MiniWindTunnelProject/The-Mini-Wind-Tunnel-Project/assets/img/about/3.jpg

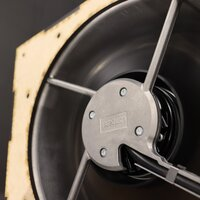
assets/img/about/3.jpg
