MiniWindTunnelProject/The-Mini-Wind-Tunnel-Project/assets/img/about/1.jpg

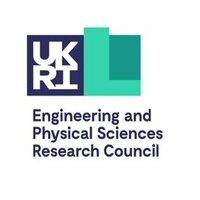
assets/img/about/1.jpg
