MiniWindTunnelProject/The-Mini-Wind-Tunnel-Project/README.md

# The-Mini-Wind-Tunnel-Project
Files to build a [mini wind tunnel](https://miniwindtunnelproject.github.io/The-Mini-Wind-Tunnel-Project/)

Files will be uploaded soon!
