MiniWindTunnelProject/The-Mini-Wind-Tunnel-Project/assets/img/about/2.jpg

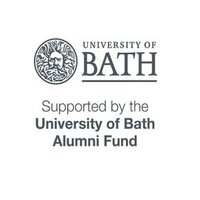
assets/img/about/2.jpg
