MiniWindTunnelProject/The-Mini-Wind-Tunnel-Project/assets/img/about/4.jpg

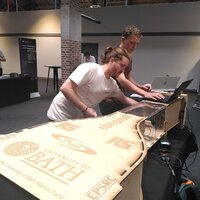
assets/img/about/4.jpg
