MiniWindTunnelProject/The-Mini-Wind-Tunnel-Project/assets/img/about/5.jpg

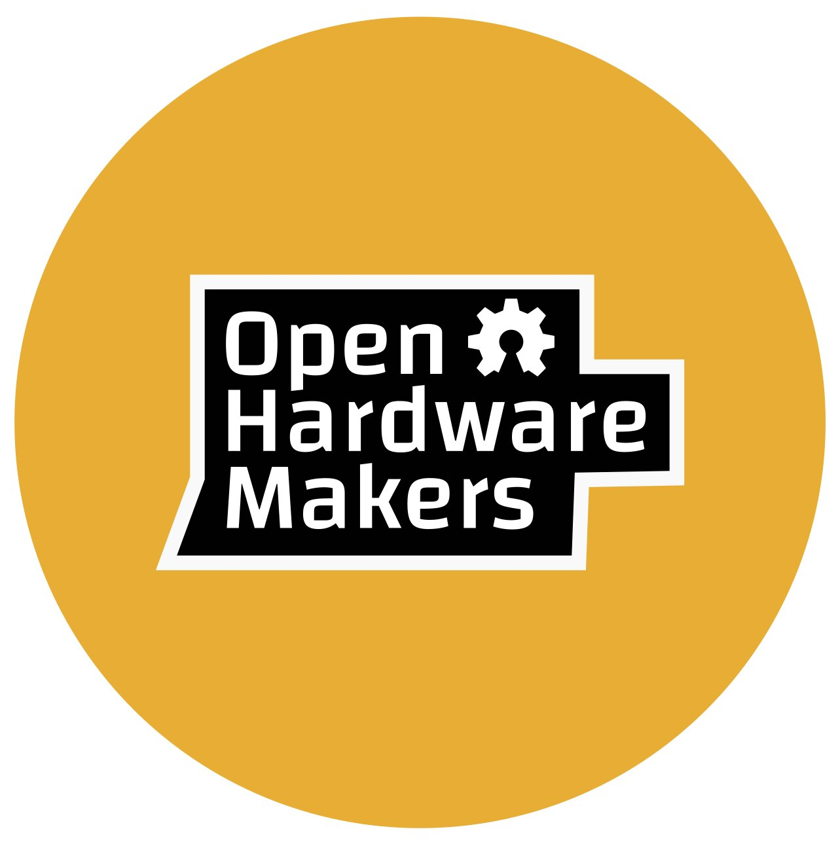
assets/img/about/5.jpg
