MiniWindTunnelProject/The-Mini-Wind-Tunnel-Project/assets/img/Mk5.png

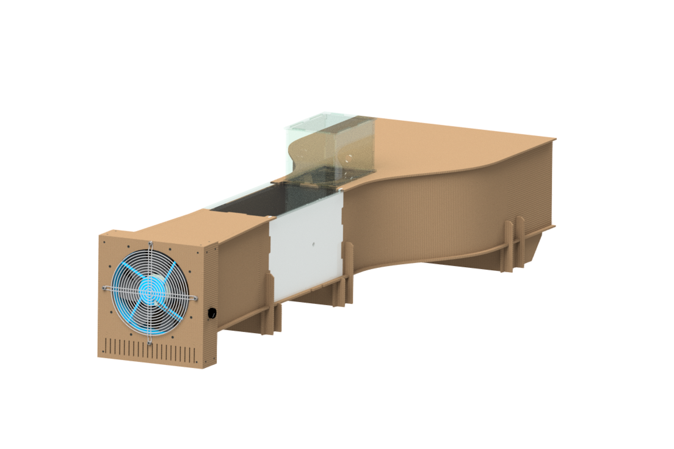
assets/img/Mk5.png
