MiniWindTunnelProject/The-Mini-Wind-Tunnel-Project/assets/img/teaching.jpg

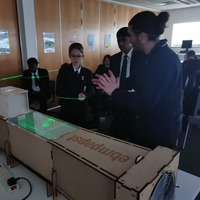
assets/img/teaching.jpg
