MiniWindTunnelProject/The-Mini-Wind-Tunnel-Project/assets/img/team/1.jpg

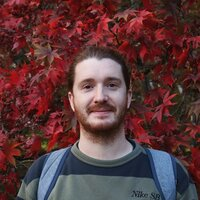
assets/img/team/1.jpg
