MiniWindTunnelProject/The-Mini-Wind-Tunnel-Project/assets/img/team/2.png

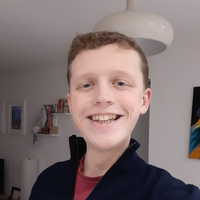
assets/img/team/2.png
