MiniWindTunnelProject/The-Mini-Wind-Tunnel-Project/assets/img/team/3.jpg

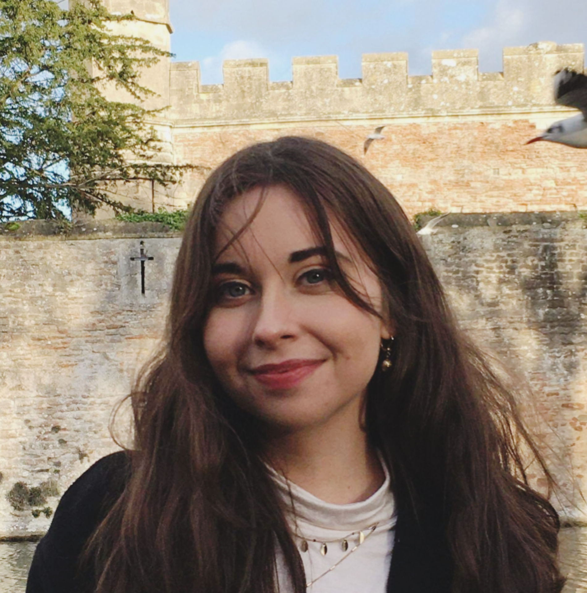
assets/img/team/3.jpg
