MiniWindTunnelProject/The-Mini-Wind-Tunnel-Project/Cost Sheet.xlsx

Powerpack | 72.07 | https://www.powersuppliesonline.co.uk/power-supplies/led-lighting-power-supplies/elg-series-mean-well/elg-300-24a-300w-24v-12-5a-led-lighting-power-supply.html
Fan | 294.21 | https://www.mouser.co.uk/ProductDetail/ebm-papst/W1G250-HJ87-02?qs=Cb2nCFKsA8o3UJP6PgA8lw%3D%3D
10 V regulator | 2.62 | https://uk.rs-online.com/web/p/voltage-regulators/5339381?matchtype=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
Control Knob | 7.57 | https://uk.rs-online.com/web/p/potentiometer-knobs/4659870
Fan Controller | 19.18 | https://uk.rs-online.com/web/p/fan-speed-controllers/7434807?matchtype=&pla-529871992272&gclsrc=aw.ds
Connector strip | 1.28 | https://www.toolstation.com/connector-strip/p19539?store=A6&pcrid=&pkw=&pmt=&gclsrc=aw.ds
M3 knurled brass inserts | 16.61 | https://uk.rs-online.com/web/p/threaded-inserts/0278534
Fan guard | 32.63 | https://uk.rs-online.com/web/p/finger-guards/2781559?matchtype=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
Nuts, Bolts, Washers |  | https://www.westfieldfasteners.co.uk/ |  | Minimum Order Quantites (MOQ) apply here. Perhaps smaller MOQs apply elsewhere? | Ebay?
 | 1.99 | 20 x Nyloc Nut Type T (Thin) M3 in A2 Stainless
 | 2.07 | 20 x Nyloc Nut Type T (Thin) M4 in A2 Stainless
 | 2.1 | 8 x Nyloc Nut Type T (Thin) M6 in A2 Stainless
 | 3.3 | 30 x Socket Head Countersunk Screw M3 x 12mm in A2 Stainless
 | 3.49 | 30 x Socket Head Countersunk Screw M3 x 20mm in A2 Stainless
 | 3.19 | 20 x Socket Head Countersunk Screw M4 x 16mm in A2 Stainless
 | 2.1 | 8 x Socket Head Countersunk Screw M6 x 16mm in A2 Stainless
 | 2.41 | 15 x DIN 9021 Washer M6 in A2 Stainless
 | 3.5 | delivery
 | 28.98 | Total + 20% VAT
Laser level | 15.82 | https://www.amazon.co.uk/Evaliss-Multipurpose-Horizontal-Rechargeable-Measuring/dp/B09F6GVCMX
Microfogger 3 lite with remote | 225 | https://levshop.co.uk/product/microfogger-3-lite
Ruler | 1.96 | https://uk.rs-online.com/web/p/rulers/1923661
Springs | 12.59 | https://uk.rs-online.com/web/p/extension-springs/0821396
Level | 2.11 | https://uk.rs-online.com/web/p/spirit-levels-inclinometers/8513539
2440 x 1220 x 6mm Flexible MDF Long Grain FSC (ring for quote) NOTE: you will need to get sydenams to break it down into manageable chunks for the laser cutter bed size. For my application, this cost £5 (3 of 700x1000mm) | 75 | https://www.sydenhams.co.uk/timber/sheet-materials/medium-density-fibreboard-(mdf)/
ESTIMATES
Laser cutting costs | 150 |  | https://www.finecut.co.uk/processes/cutting/laser-cutting/
3D printing costs | 100 |  | 3dpeople.uk
Grand Total | 1057.63
