MiniWindTunnelProject/The-Mini-Wind-Tunnel-Project/Mini Wind Tunnel Files/3D print/CornerPiece.stp

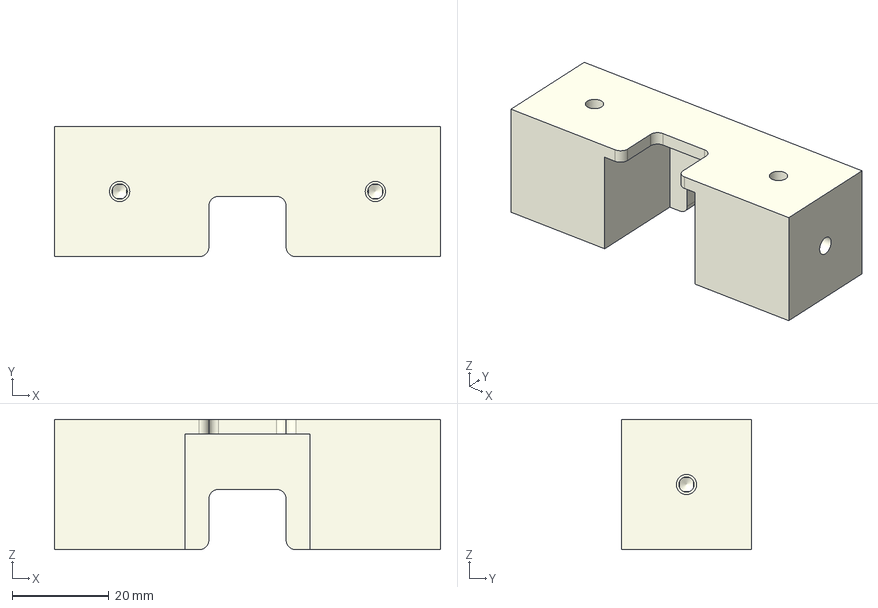
[picture p11: CAD file, 2022-11-02]
Mini Wind Tunnel Files/3D print/CornerPiece.stp
80.0 x 27.0 x 27.0 mm
