MiniWindTunnelProject/The-Mini-Wind-Tunnel-Project/Mini Wind Tunnel Files/Laser Cut Drawings/6mm Acryllic/SmokeBox.dxf

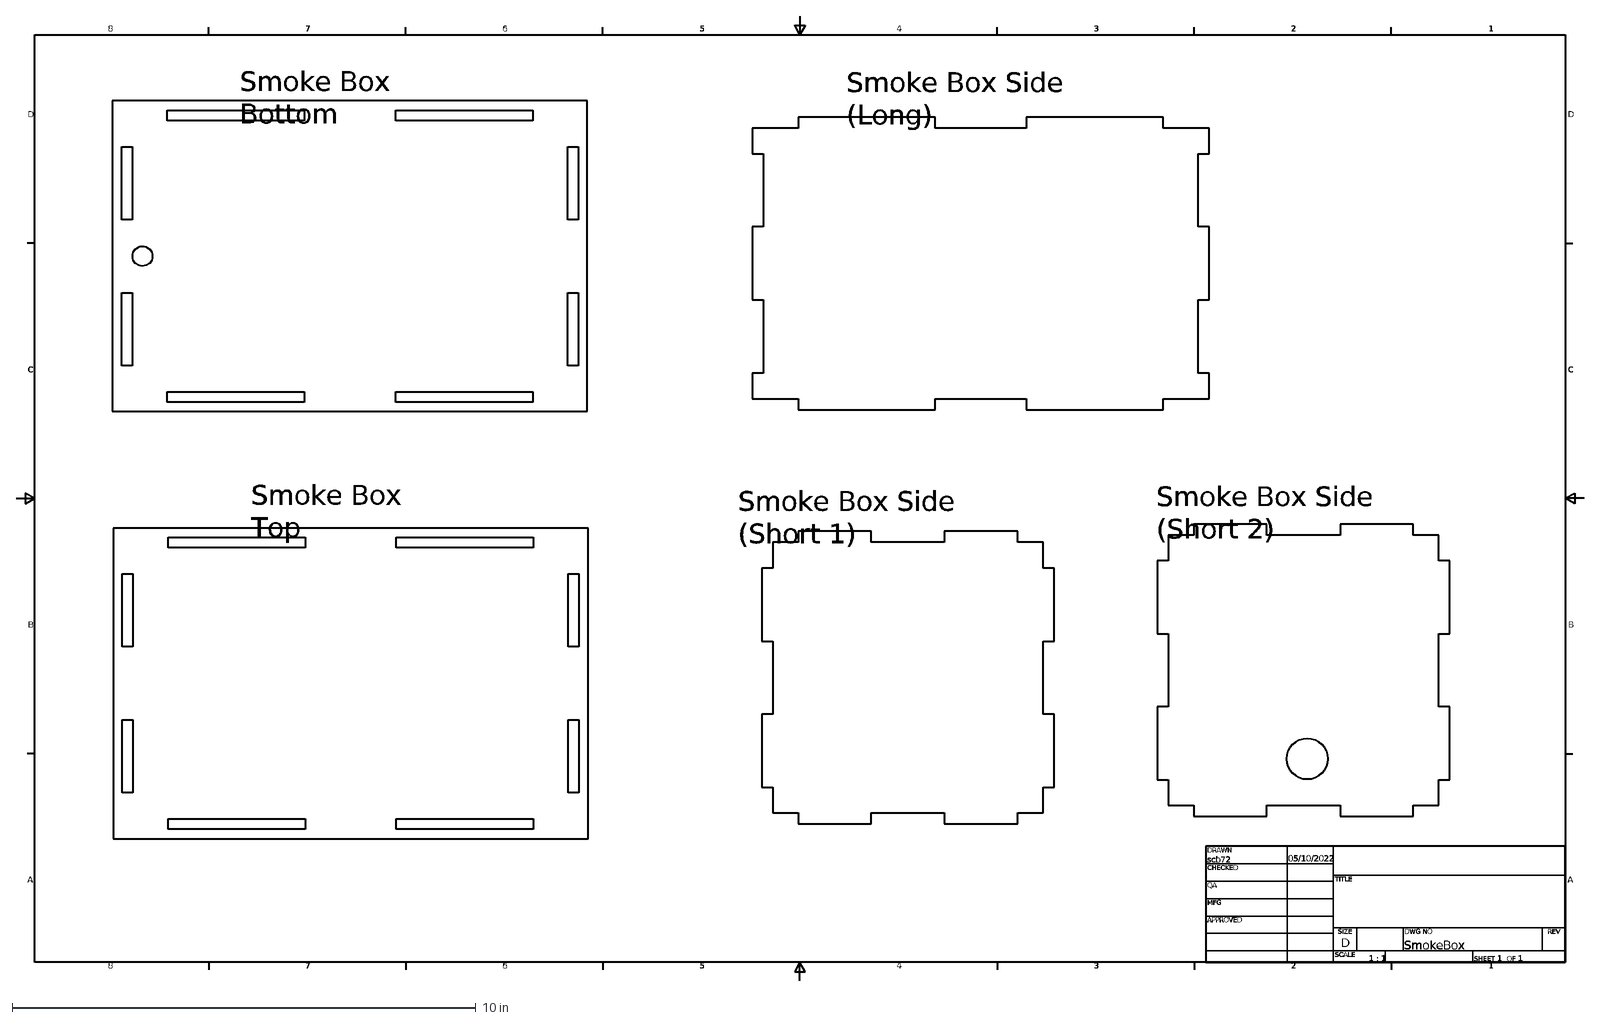
[picture p12: CAD file, 2022-11-02]
Mini Wind Tunnel Files/Laser Cut Drawings/6mm Acryllic/SmokeBox.dxf
1
2
3
4
5
6
7
8
A
B
C
D
scb72
05/10/2022
SmokeBox
1 : 1
SHEET 1 OF 1
DRAWN
CHECKED
QA
MFG
APPROVED
DWG NO
TITLE
SIZE
SCALE
REV
Smoke Box Bottom
Smoke Box Top
Smoke Box Side (Long)
Smoke Box Side (Short 1)
Smoke Box Side (Short 2)
