MiniWindTunnelProject/The-Mini-Wind-Tunnel-Project/Mini Wind Tunnel Files/Laser Cut Drawings/6mm MDF/LaserHolder.dxf

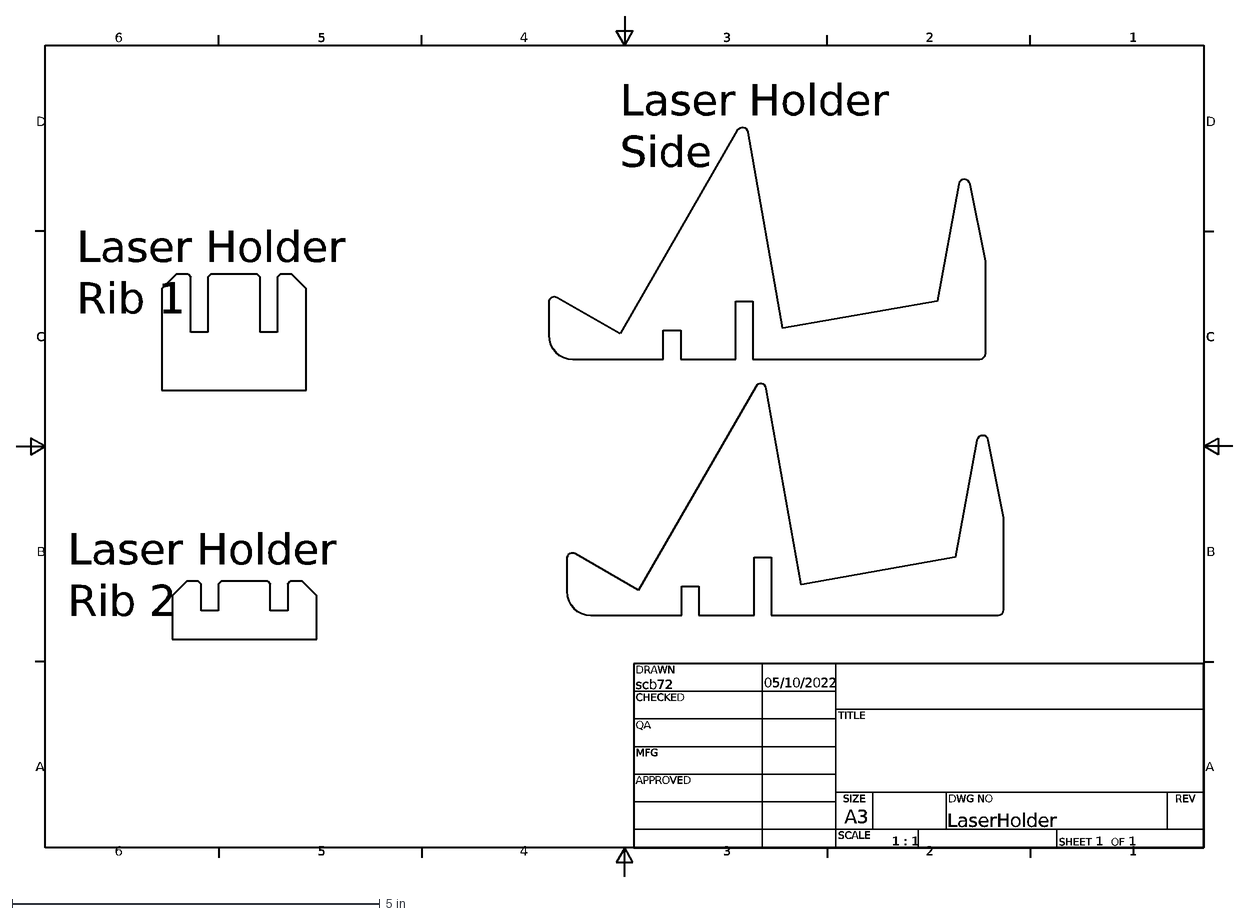
[picture p13: CAD file, 2022-11-02]
Mini Wind Tunnel Files/Laser Cut Drawings/6mm MDF/LaserHolder.dxf
1
2
3
4
5
6
A
B
C
D
scb72
05/10/2022
LaserHolder
A3
1 : 1
SHEET 1 OF 1
DRAWN
CHECKED
QA
MFG
APPROVED
DWG NO
TITLE
SIZE
SCALE
REV
Laser Holder Side
Laser Holder Rib 1
Laser Holder Rib 2
