MiniWindTunnelProject/The-Mini-Wind-Tunnel-Project/(list of files, cad)

Other CAD files:
Mini Wind Tunnel Files/Countersink locations/Motorbox Fan Front.dwg
Mini Wind Tunnel Files/Laser Cut Drawings/6mm Acryllic/Test Section.dxf
Mini Wind Tunnel Files/Laser Cut Drawings/6mm Flex MDF/Contraction.dxf
Mini Wind Tunnel Files/Laser Cut Drawings/6mm MDF/Diffuser.dxf
Mini Wind Tunnel Files/Countersink locations/Motorbox side 1.dwg
Mini Wind Tunnel Files/Laser Cut Drawings/6mm Flex MDF/Diffuser.dxf
Mini Wind Tunnel Files/Laser Cut Drawings/6mm MDF/Contraction.dxf
Mini Wind Tunnel Files/Countersink locations/Motorbox top.dwg
Mini Wind Tunnel Files/Laser Cut Drawings/6mm MDF/Motorbox.dxf
Mini Wind Tunnel Files/Countersink locations/Motorbox Fan Front 2.dwg
Mini Wind Tunnel Files/Laser Cut Drawings/6mm MDF/Test Section_Sheet.dxf
Mini Wind Tunnel Files/Countersink locations/Motorbox corner piece.dwg
Mini Wind Tunnel Files/Laser Cut Drawings/6mm MDF/Test Section.dwg
Mini Wind Tunnel Files/Countersink locations/Motorbox Bottom.dwg
Mini Wind Tunnel Files/Countersink locations/Motorbox side 2.dwg
Mini Wind Tunnel Files/Countersink locations/Motorbox Fan Back.dwg
Mini Wind Tunnel Files/3D print/CornerPiece.ipt
Mini Wind Tunnel Files/3D print/CornerPiece.stl
Mini Wind Tunnel Files/Laser Cut Drawings/6mm Acryllic/SmokeBox.dwg
Mini Wind Tunnel Files/Laser Cut Drawings/6mm Acryllic/Test Section.dwg
Mini Wind Tunnel Files/Laser Cut Drawings/6mm Flex MDF/Contraction.dwg
Mini Wind Tunnel Files/Laser Cut Drawings/6mm Flex MDF/Diffuser.dwg
Mini Wind Tunnel Files/Laser Cut Drawings/6mm MDF/Contraction.dwg
Mini Wind Tunnel Files/Laser Cut Drawings/6mm MDF/Diffuser.dwg
Mini Wind Tunnel Files/Laser Cut Drawings/6mm MDF/LaserHolder.dwg
Mini Wind Tunnel Files/Laser Cut Drawings/6mm MDF/Motorbox.dwg
