MiniWindTunnelProject/The-Mini-Wind-Tunnel-Project/Mini Wind Tunnel Files/Fan Wiring.docx

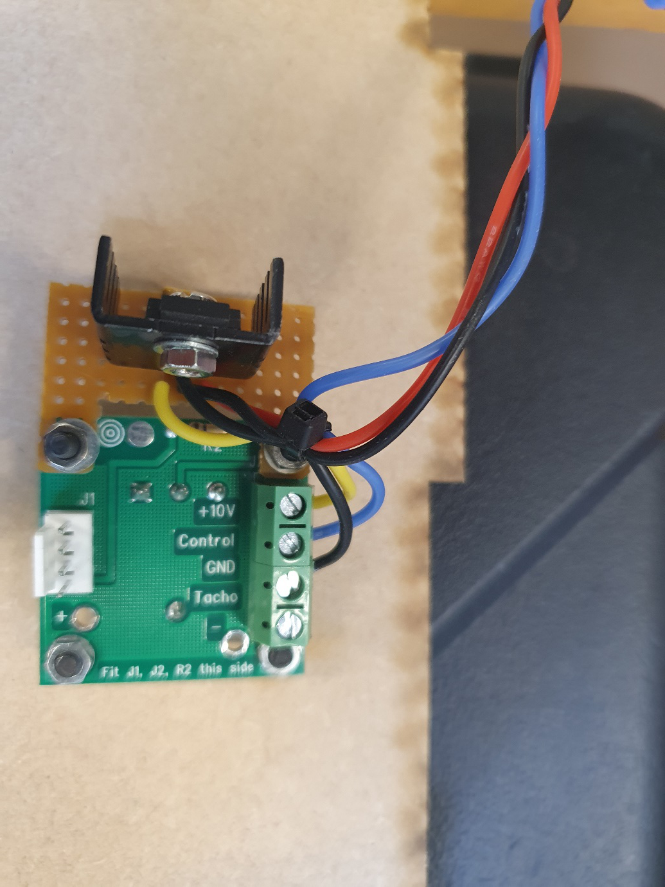
[picture p14: figure]

The speed is controlled using a10K potentiometer which is mounted on a PCB

The supply used is 10V from a 10V regulator, the heat sink is from CPC, order code 170072.

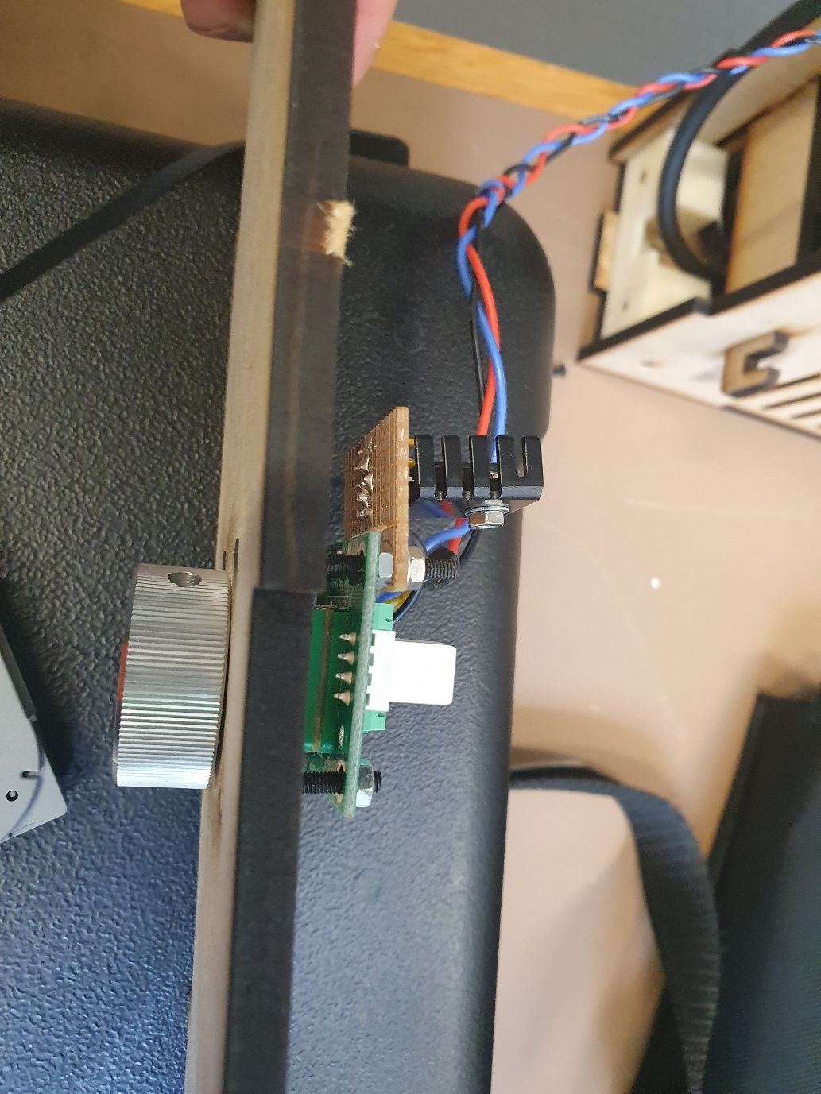
[picture p15: figure]

View from the top

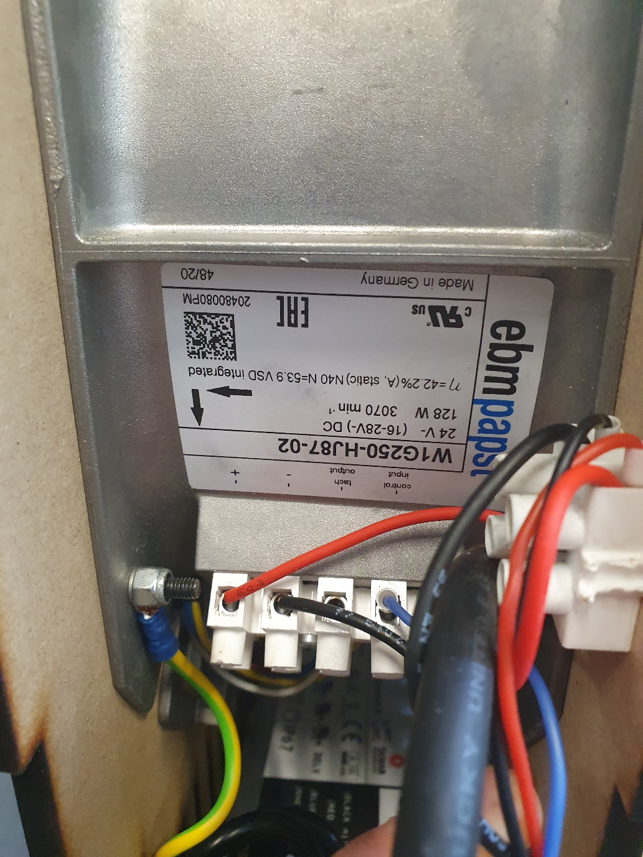
[picture p16: figure]

The Fan details, 24V coming in on red and black wires and the speed demand coming in on the blue wire.

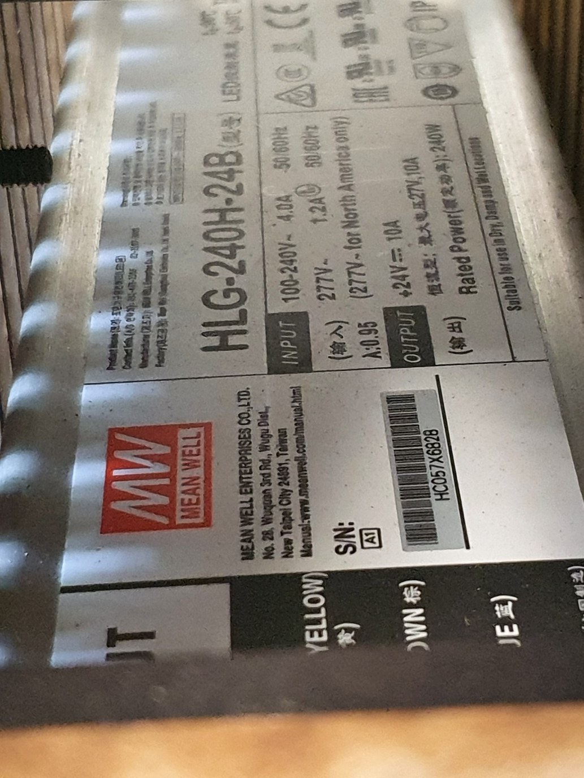
[picture p17: figure]

This is power supply for the Fan 24V.

So a simple setup with 0-10V demand for the speed from the 10K pot and a power supply to supply the Fan.
