MiniWindTunnelProject/The-Mini-Wind-Tunnel-Project/assets/img/GitBuildingScreenshot.JPG

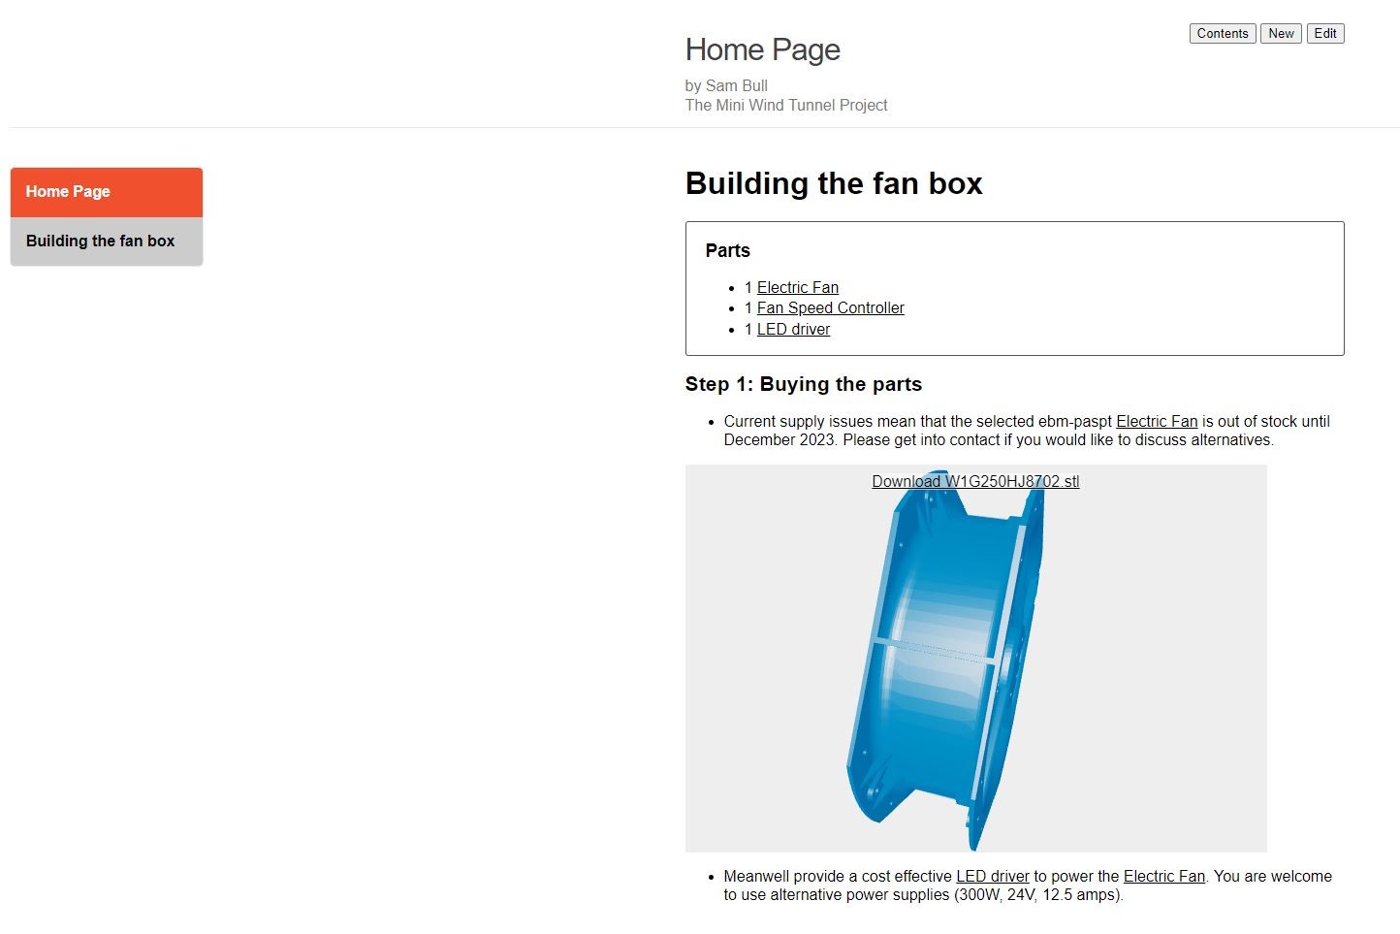
assets/img/GitBuildingScreenshot.JPG
