MiniWindTunnelProject/The-Mini-Wind-Tunnel-Project/Mini Wind Tunnel Files/Assembly Drawings/Laser Holder/LaserHolder.pdf

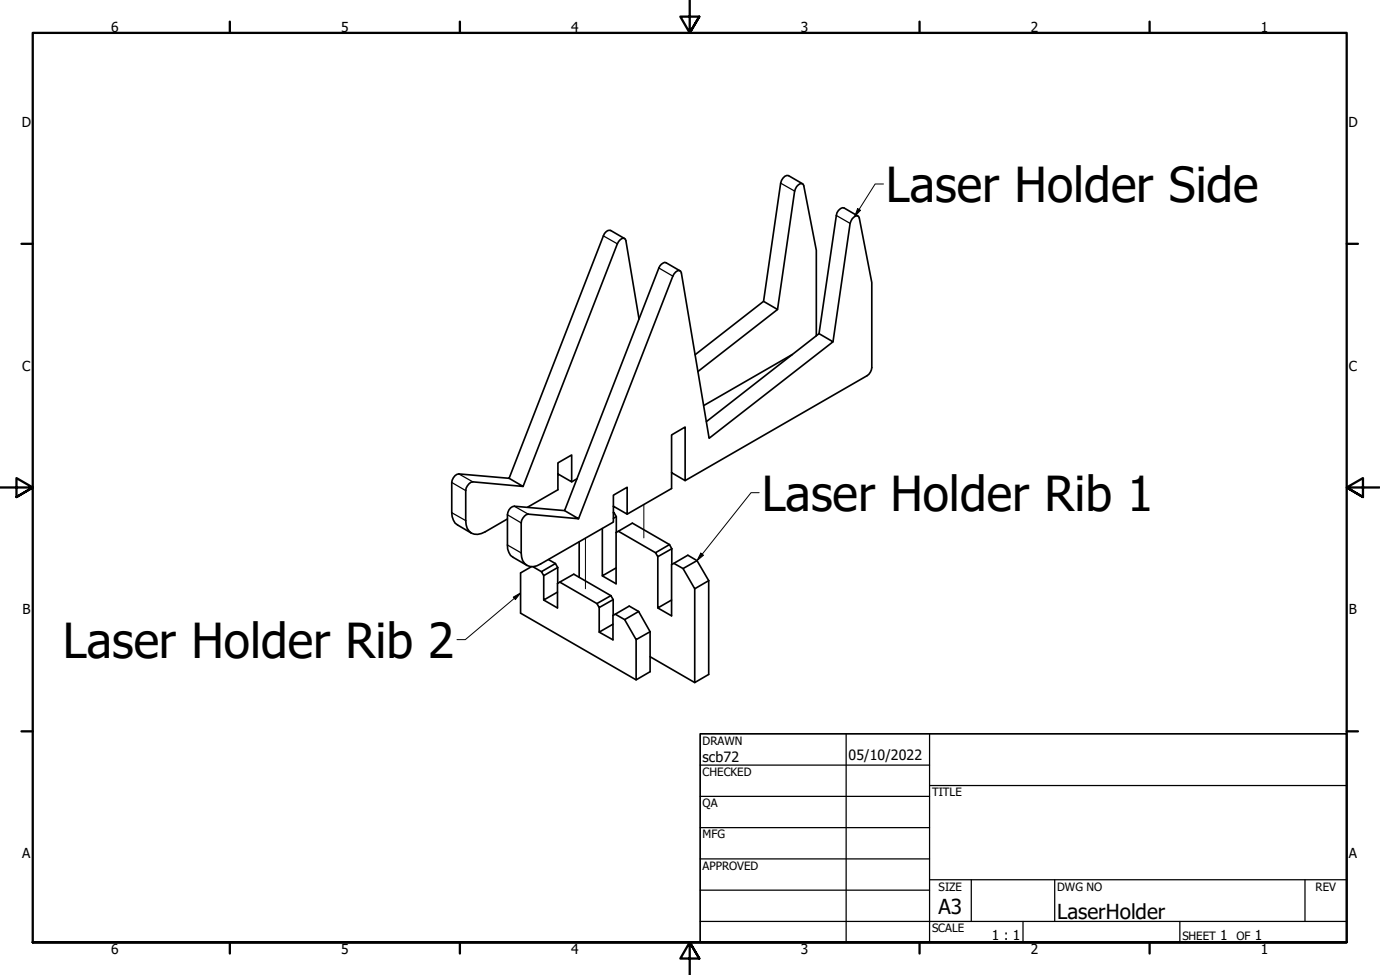
[picture p19: page 1]

Laser Holder Side

Laser Holder Rib 1

Laser Holder Rib 2

DRAWN scb72 | 05/10/2022

CHECKED

MFG

APPROVED

SIZE A3 | DWG NO LaserHolder | REV

SCALE 1 : 1 | | SHEET 1 OF 1
