MiniWindTunnelProject/The-Mini-Wind-Tunnel-Project/Mini Wind Tunnel Files/Assembly Drawings/Motorbox/Motorbox Bottom_cornerpiece assembly.pdf

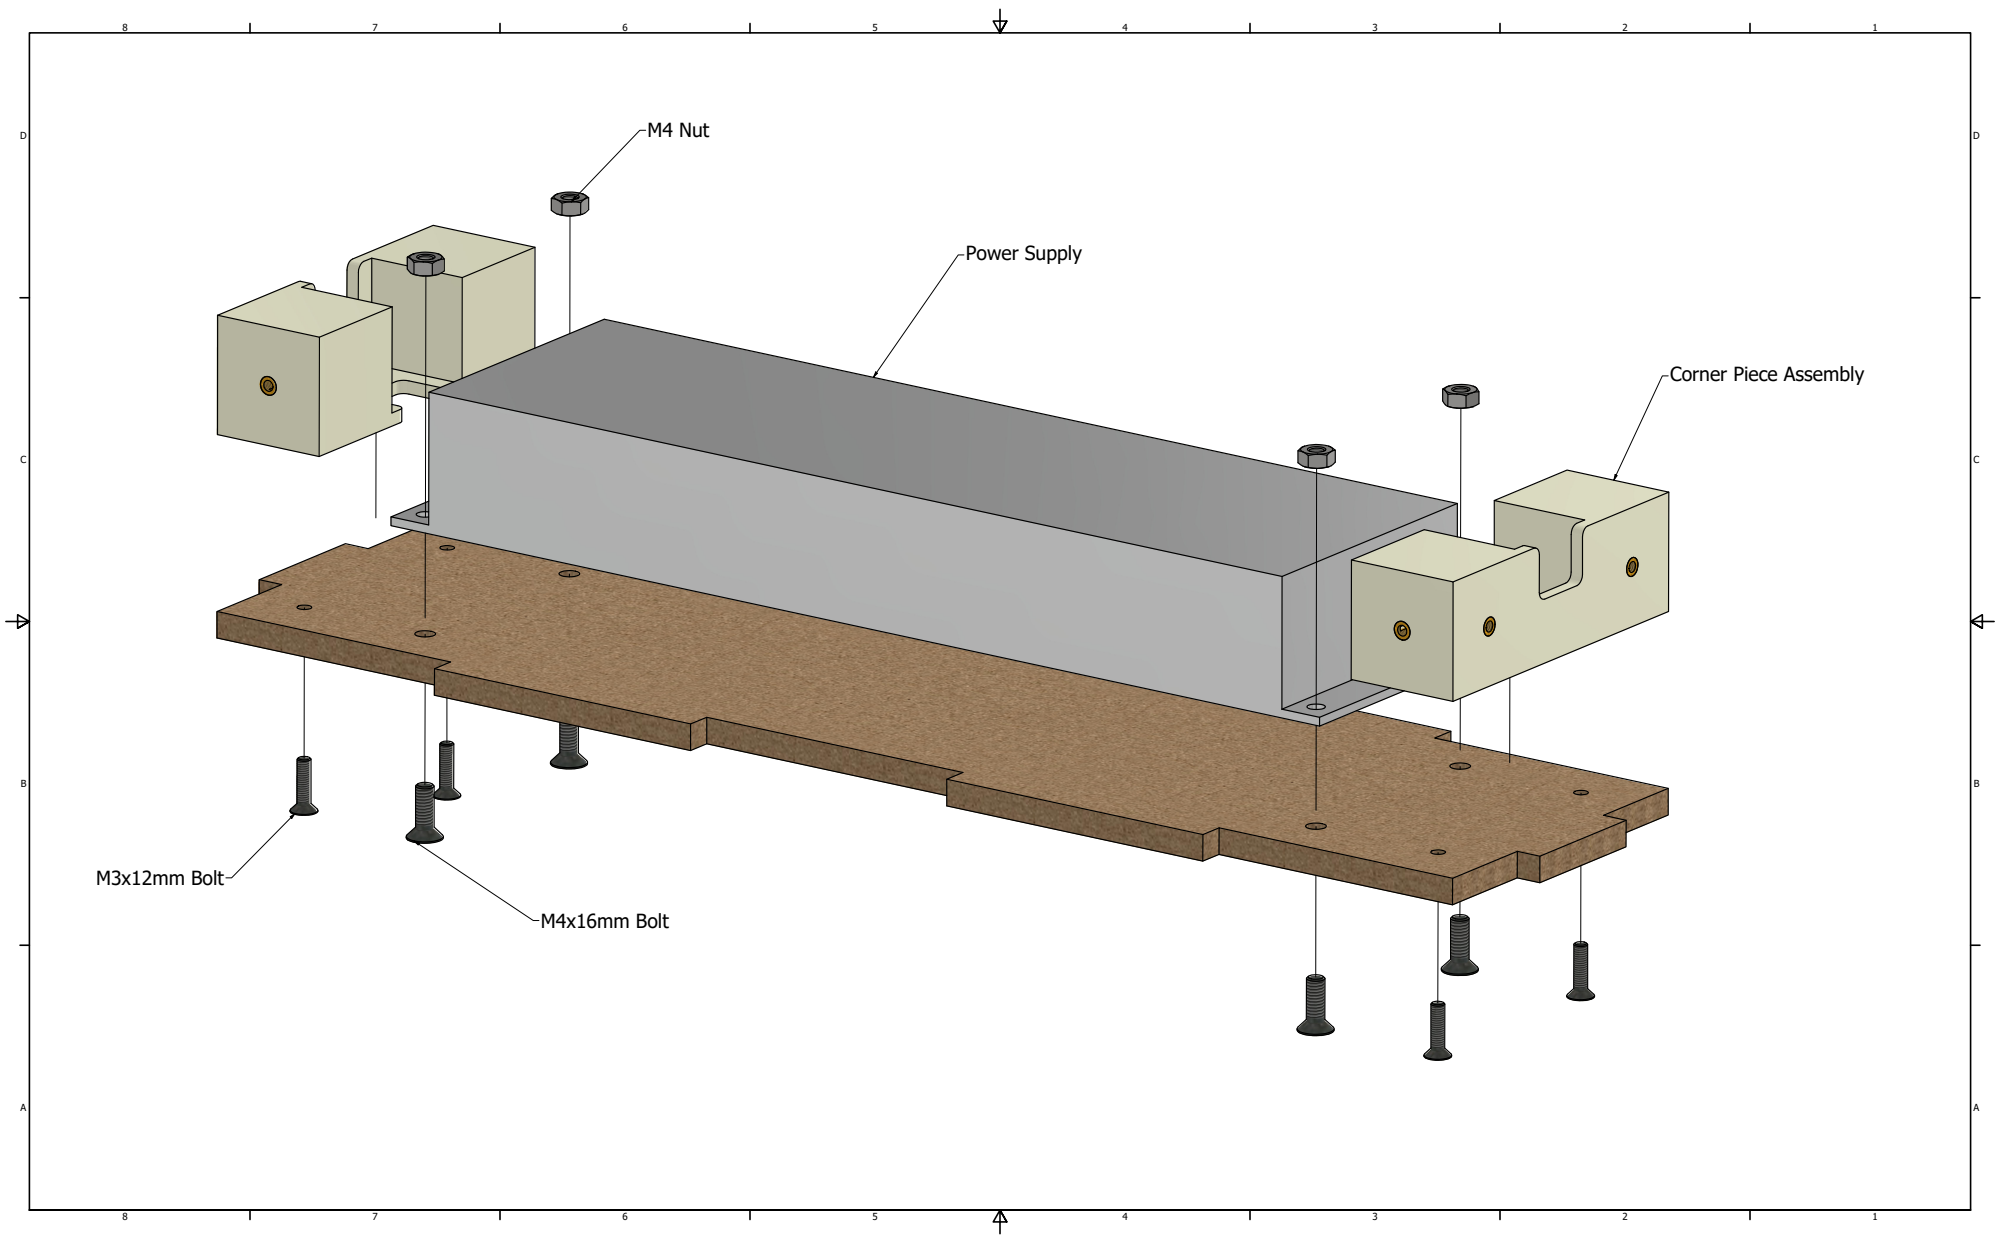
[picture p20: page 1]
Power Supply; M4 Nut; M4x16mm Bolt; M3x12mm Bolt

Corner Piece Assembly
