MiniWindTunnelProject/The-Mini-Wind-Tunnel-Project/Mini Wind Tunnel Files/Assembly Drawings/Motorbox/Motorbox Top_cornerpiece assembly.pdf

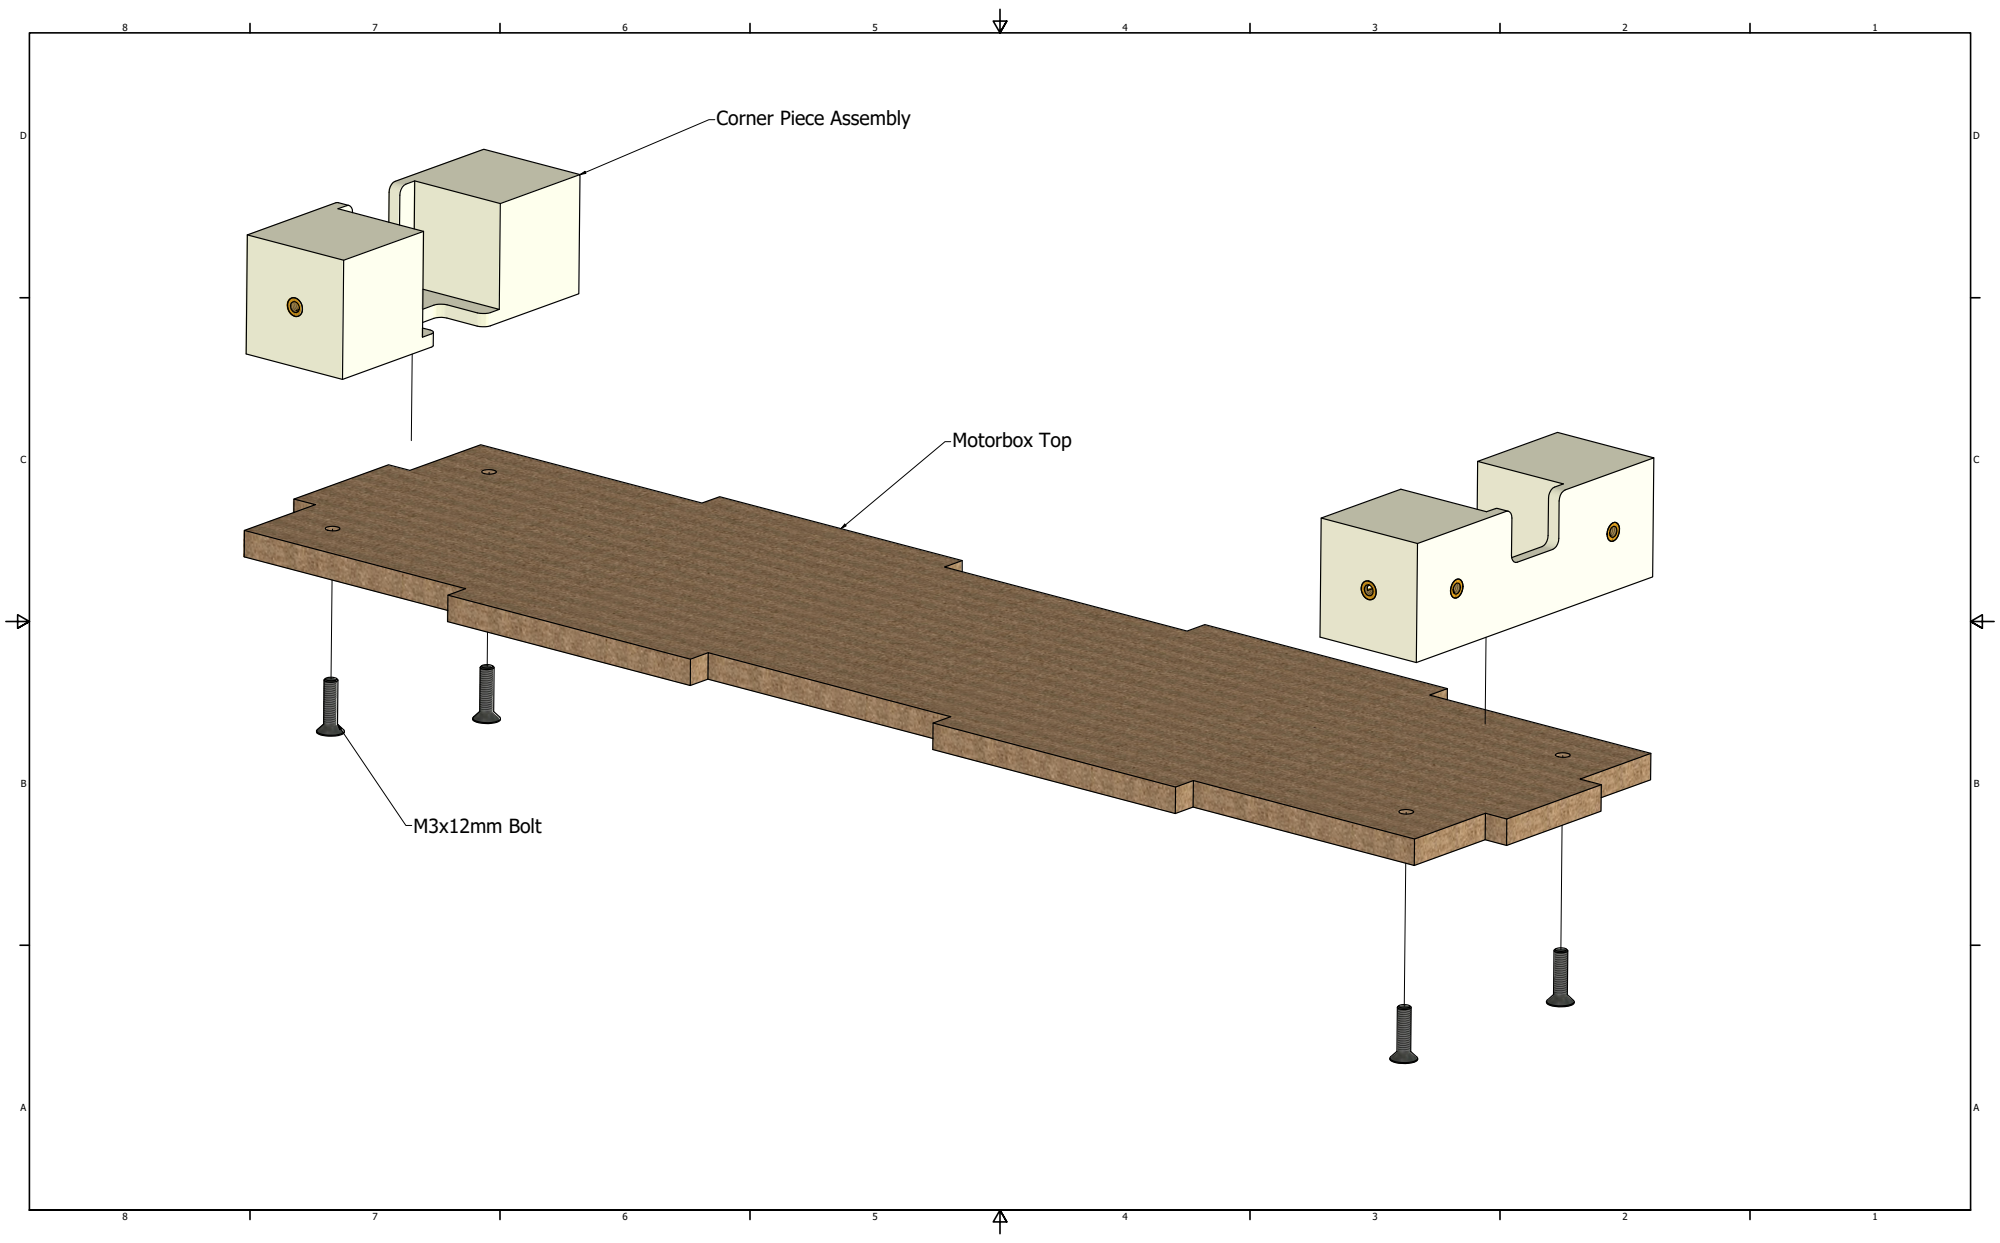
[picture p21: page 1]
Motorbox Top; M3x12mm Bolt

Corner Piece Assembly
