MiniWindTunnelProject/The-Mini-Wind-Tunnel-Project/Mini Wind Tunnel Files/Assembly Drawings/Motorbox/MotorBox_frontback.pdf

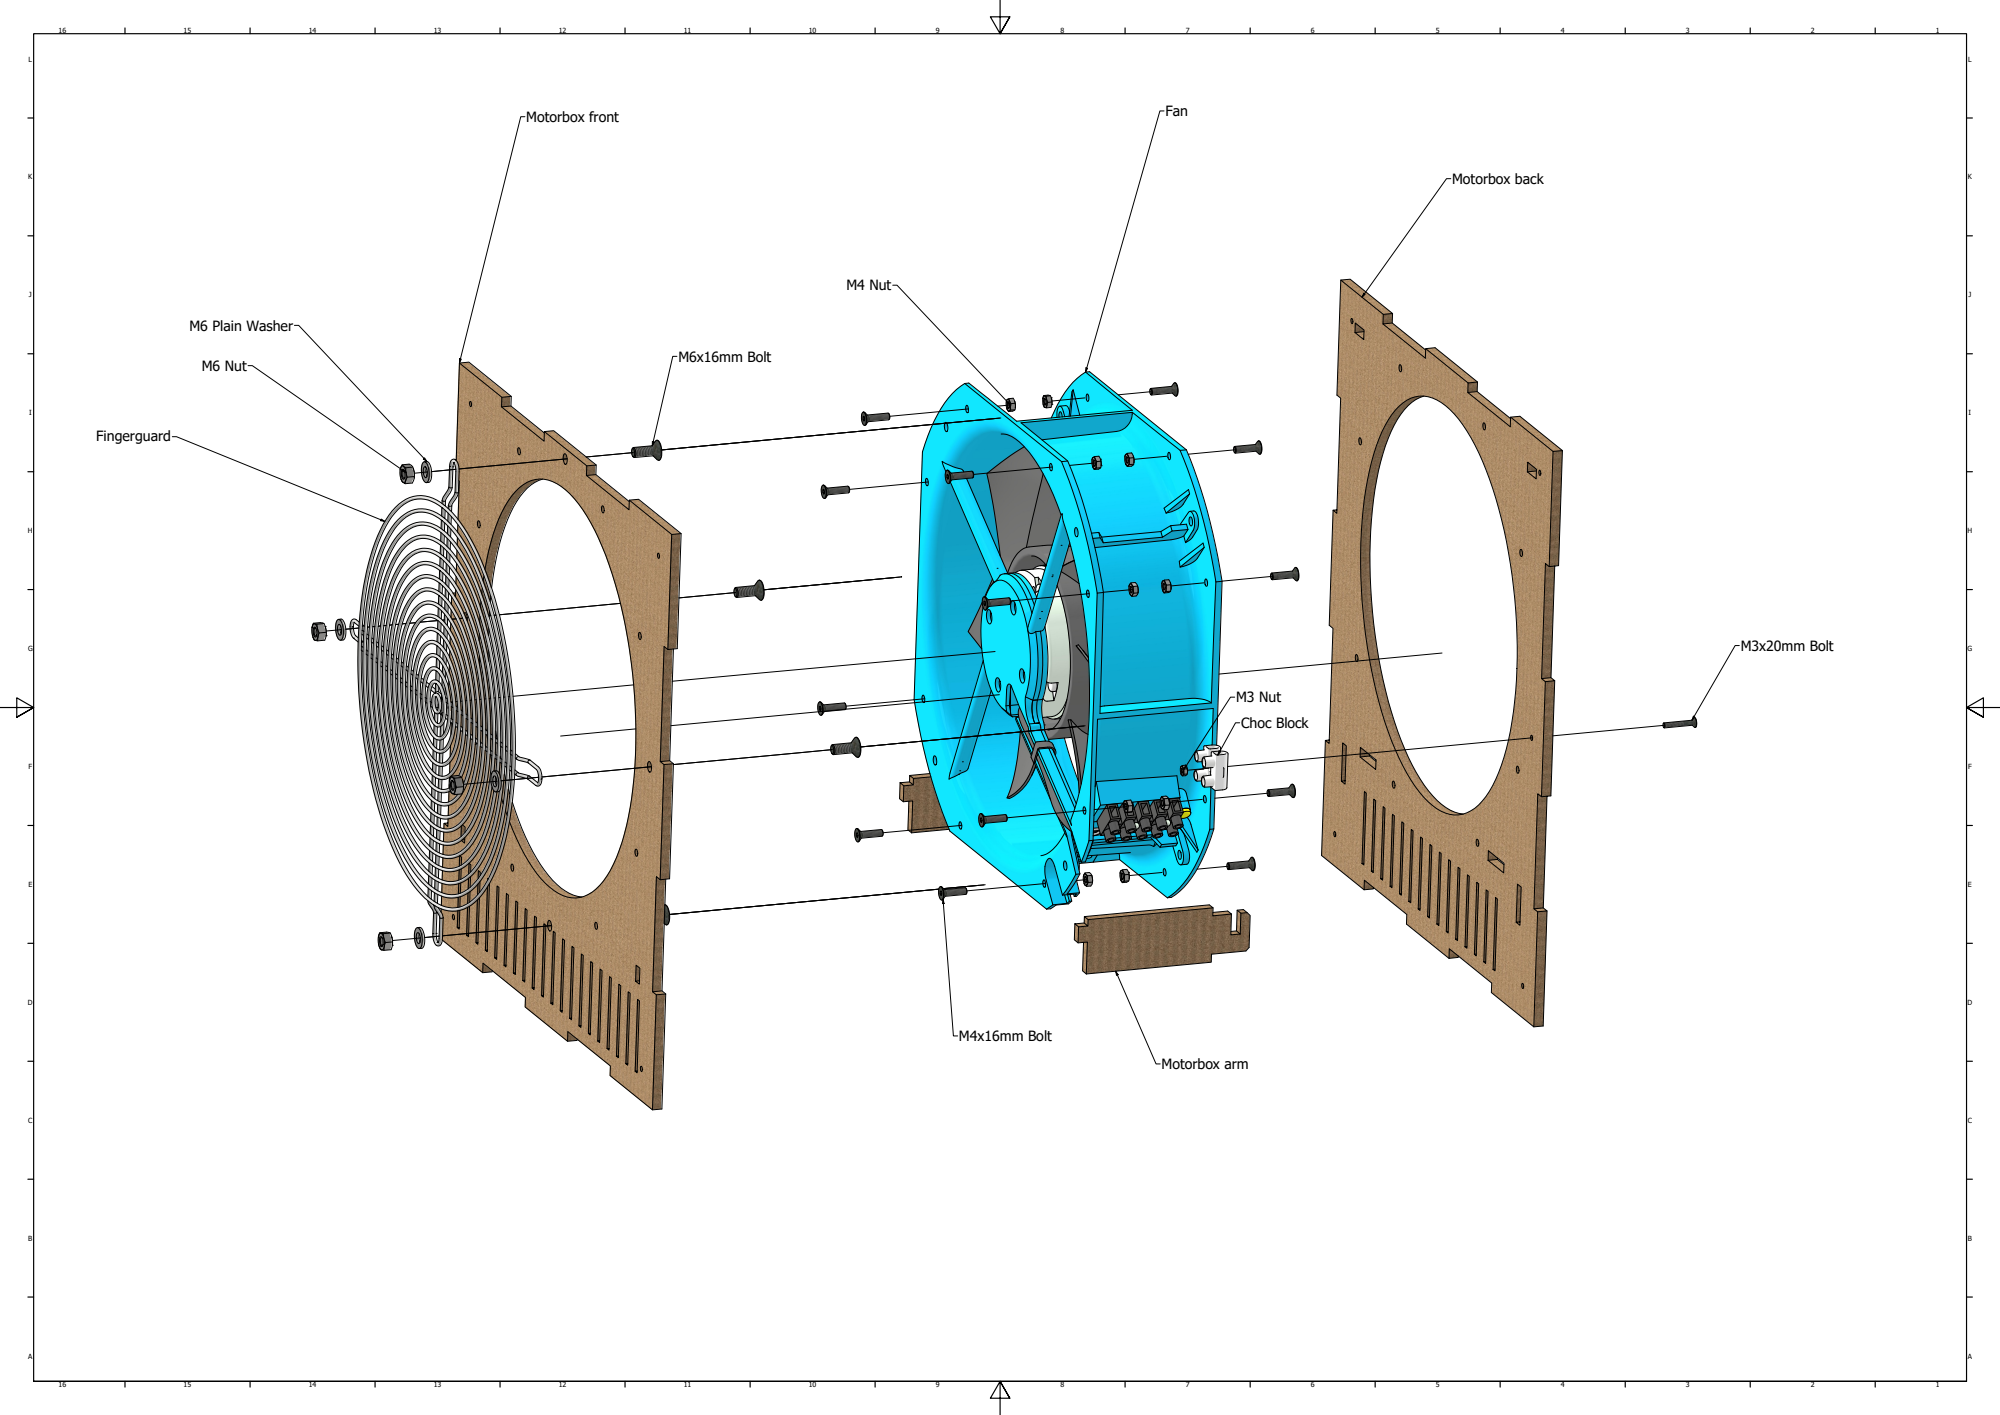
[picture p22: page 1]
Motorbox back; Motorbox front; M3x20mm Bolt; Motorbox arm; M4x16mm Bolt; M4 Nut; M6x16mm Bolt; M6 Nut; M6 Plain Washer; Choc Block; M3 Nut
