MiniWindTunnelProject/The-Mini-Wind-Tunnel-Project/Mini Wind Tunnel Files/Assembly Drawings/Motorbox/Side_Controller.pdf

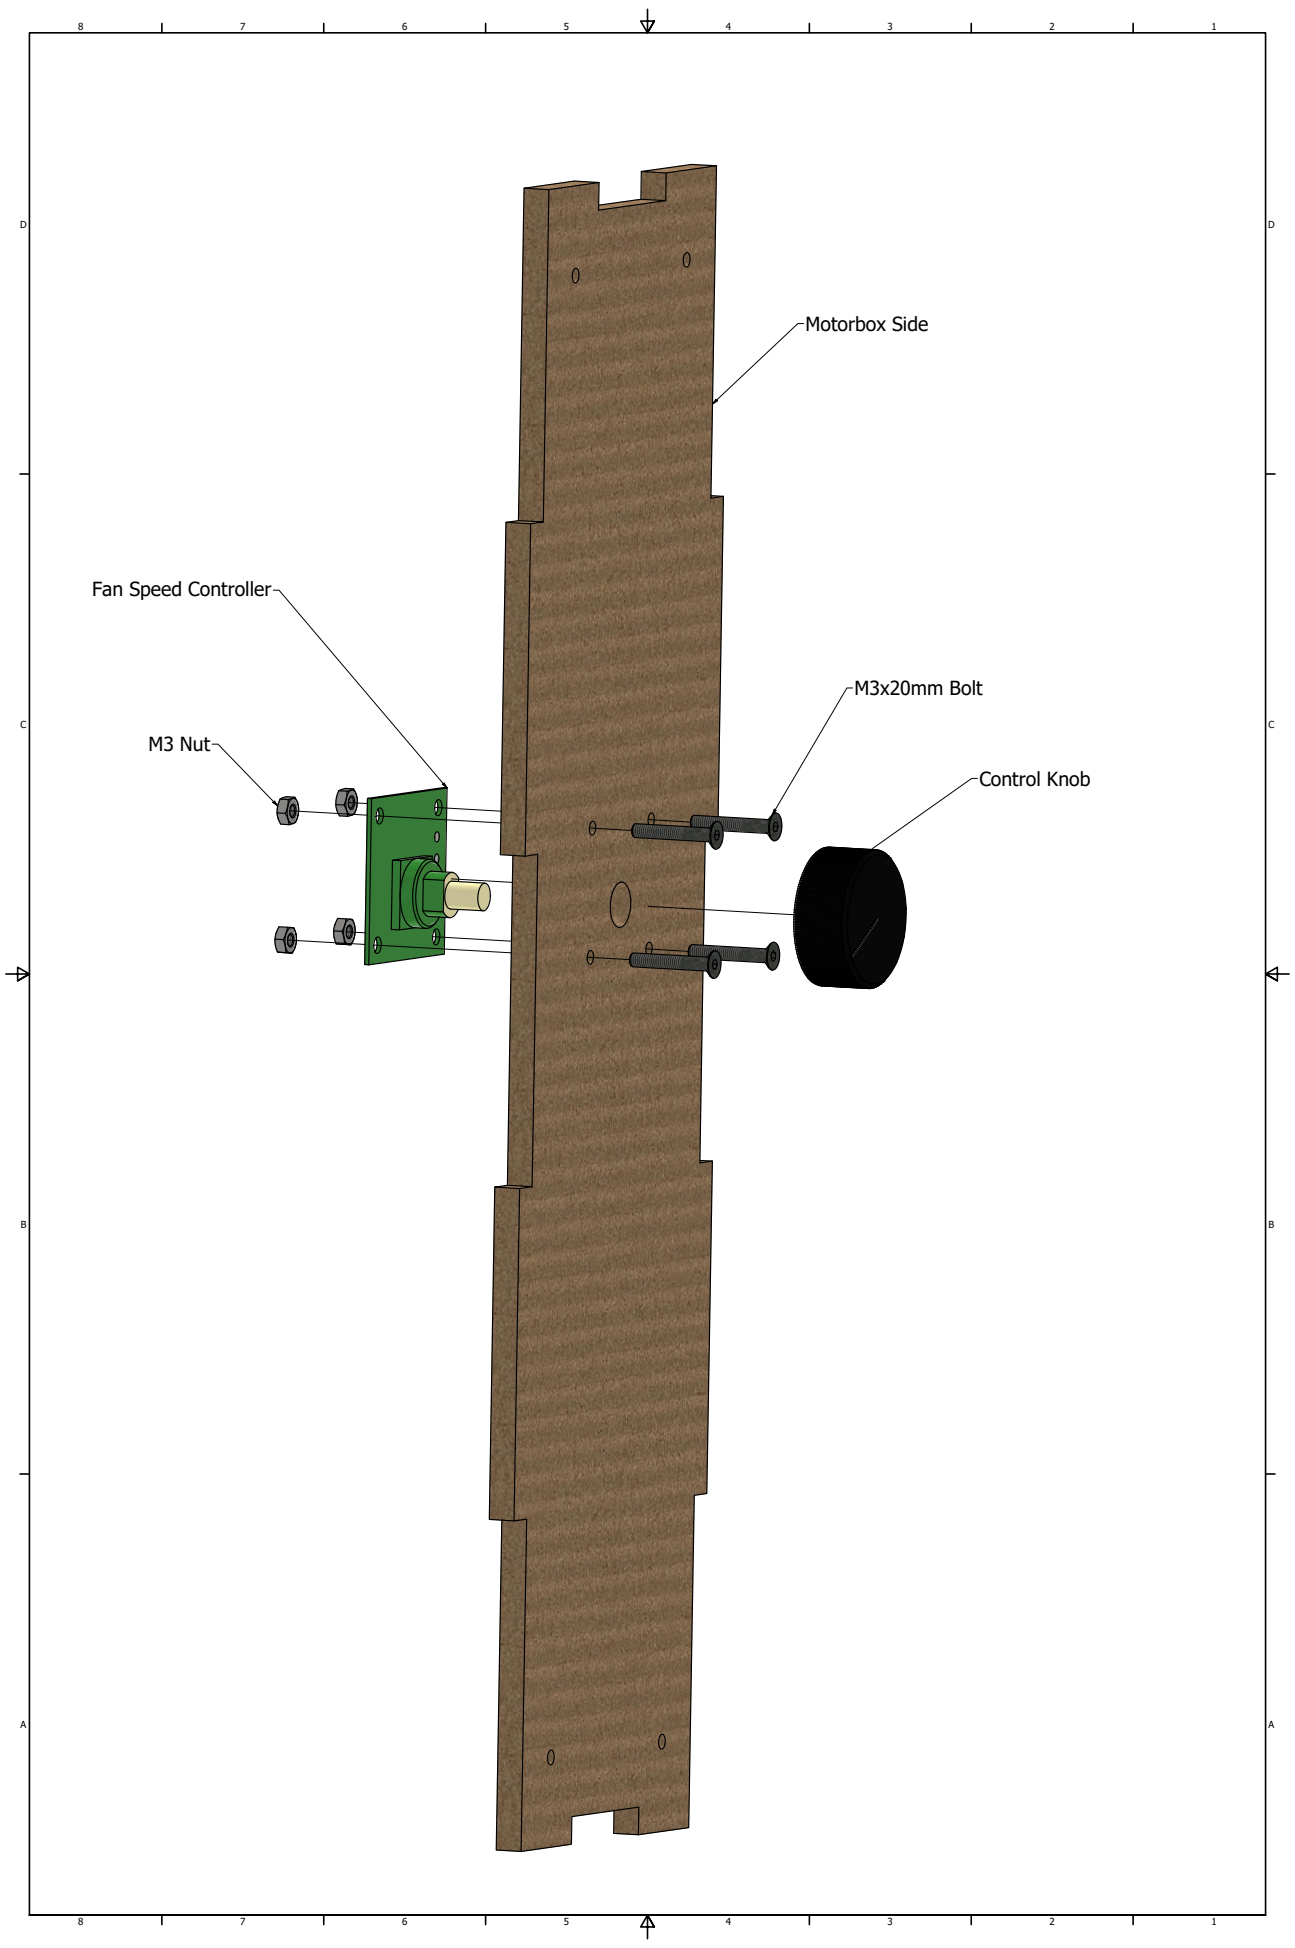
[picture p23: page 1]
Control Knob; M3x20mm Bolt; Motorbox Side; M3 Nut

Fan Speed Controller
