MiniWindTunnelProject/The-Mini-Wind-Tunnel-Project/Mini Wind Tunnel Files/Assembly Drawings/Test Section/TestSection.pdf

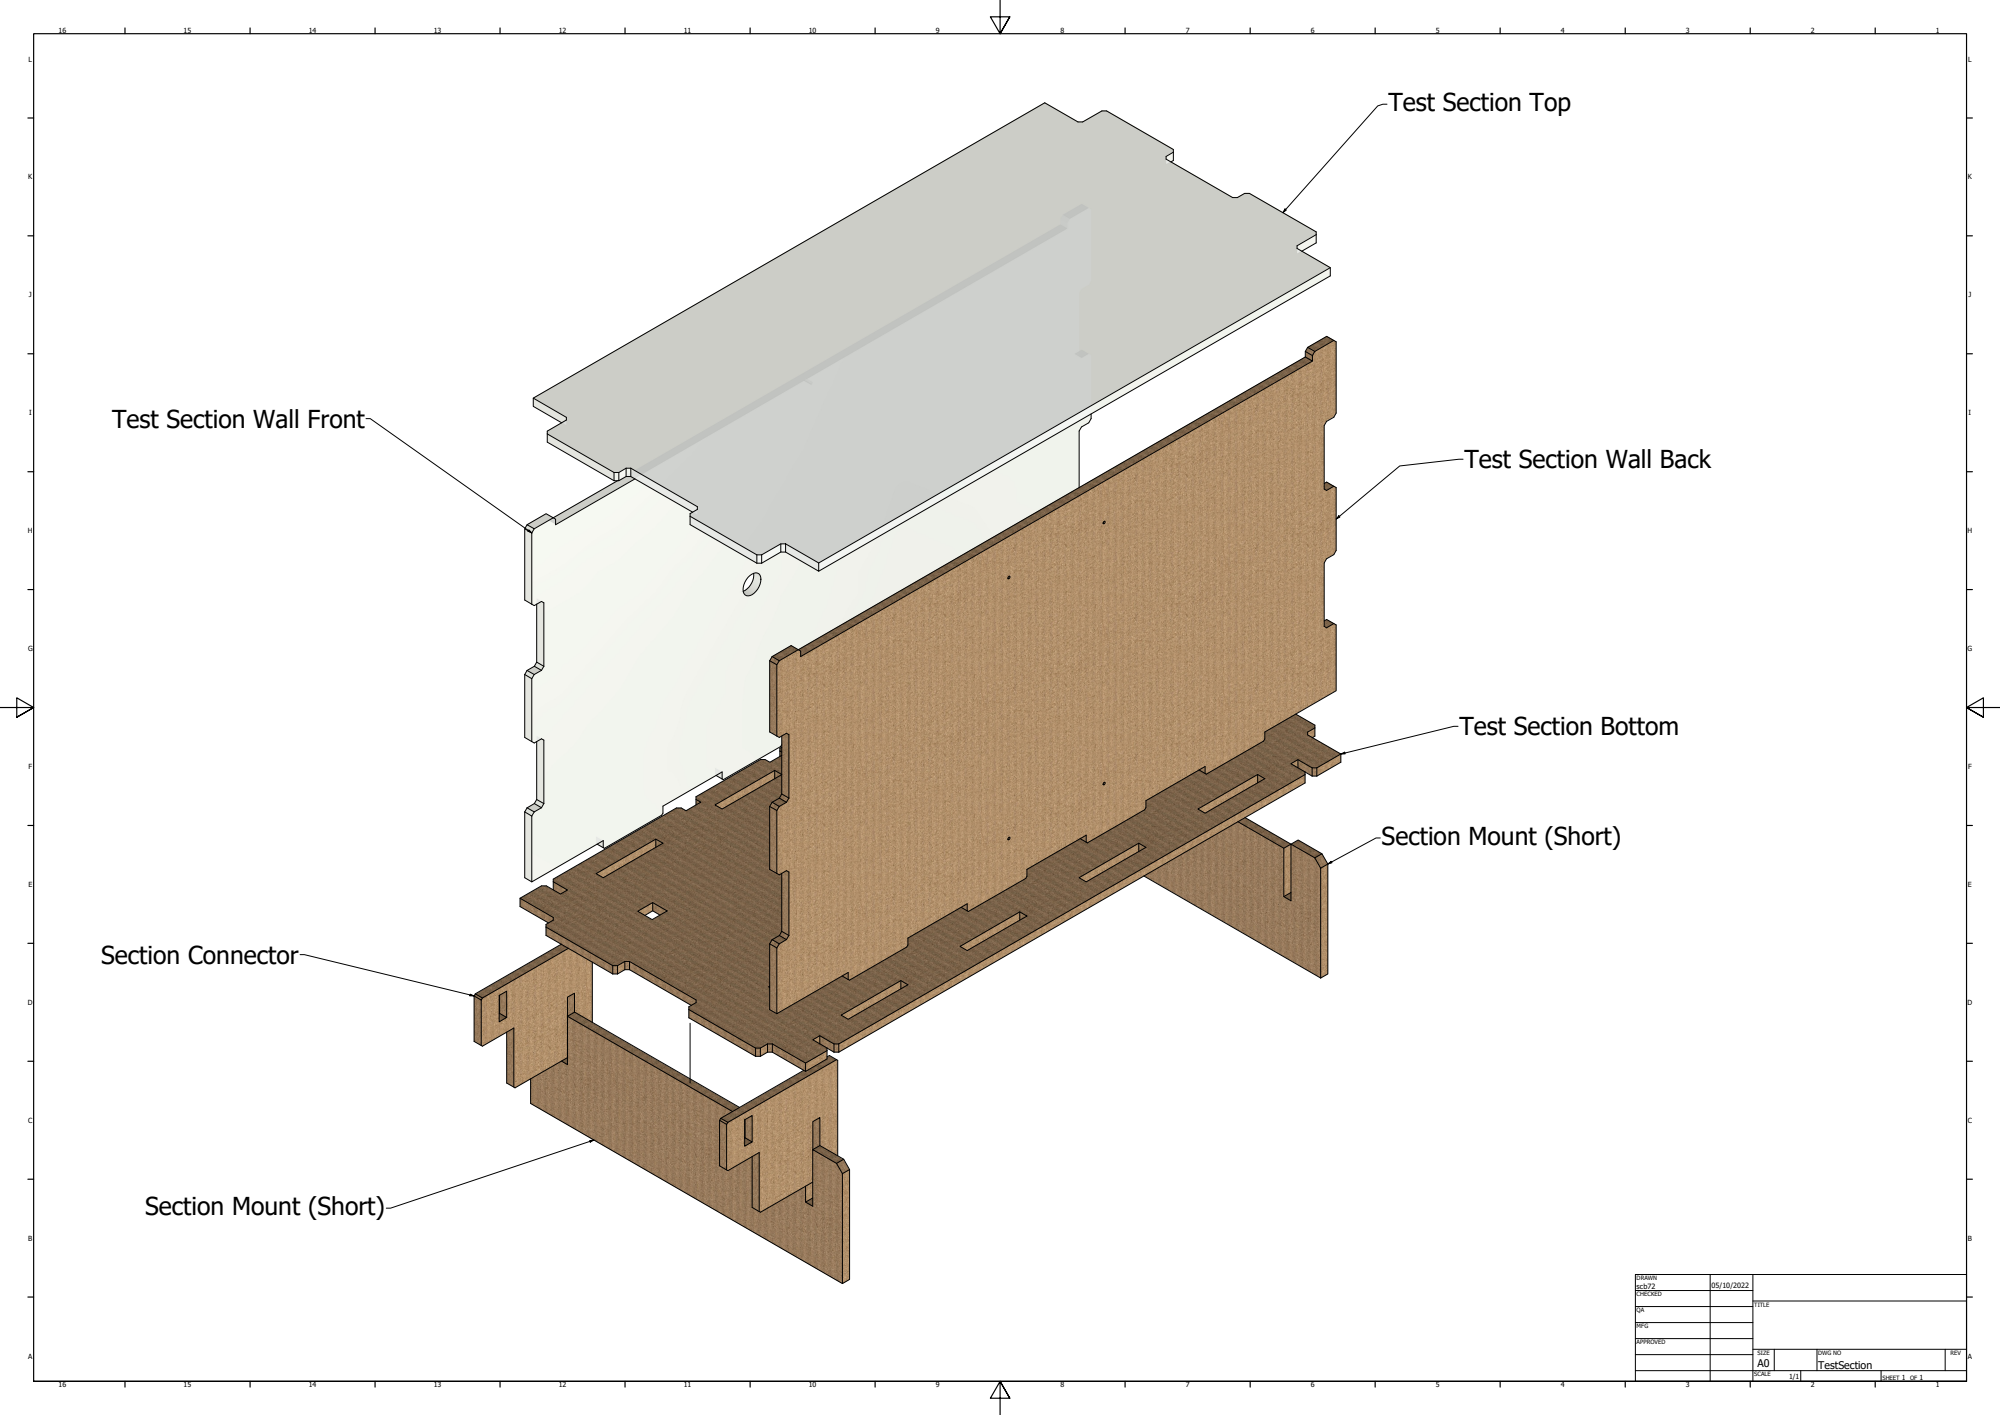
[picture p24: page 1]
Section Connector

Test Section Top

Test Section Wall Front

Test Section Wall Back

Test Section Bottom

Section Mount (Short)

DRAWN scb72 | 05/10/2022

CHECKED

MFG

APPROVED

SIZE A0 | DWG NO TestSection | REV

SCALE 1/1 | | SHEET 1 OF 1
