MiniWindTunnelProject/The-Mini-Wind-Tunnel-Project/Mini Wind Tunnel Files/Laser Cut Drawings/6mm MDF/Test Section.pdf

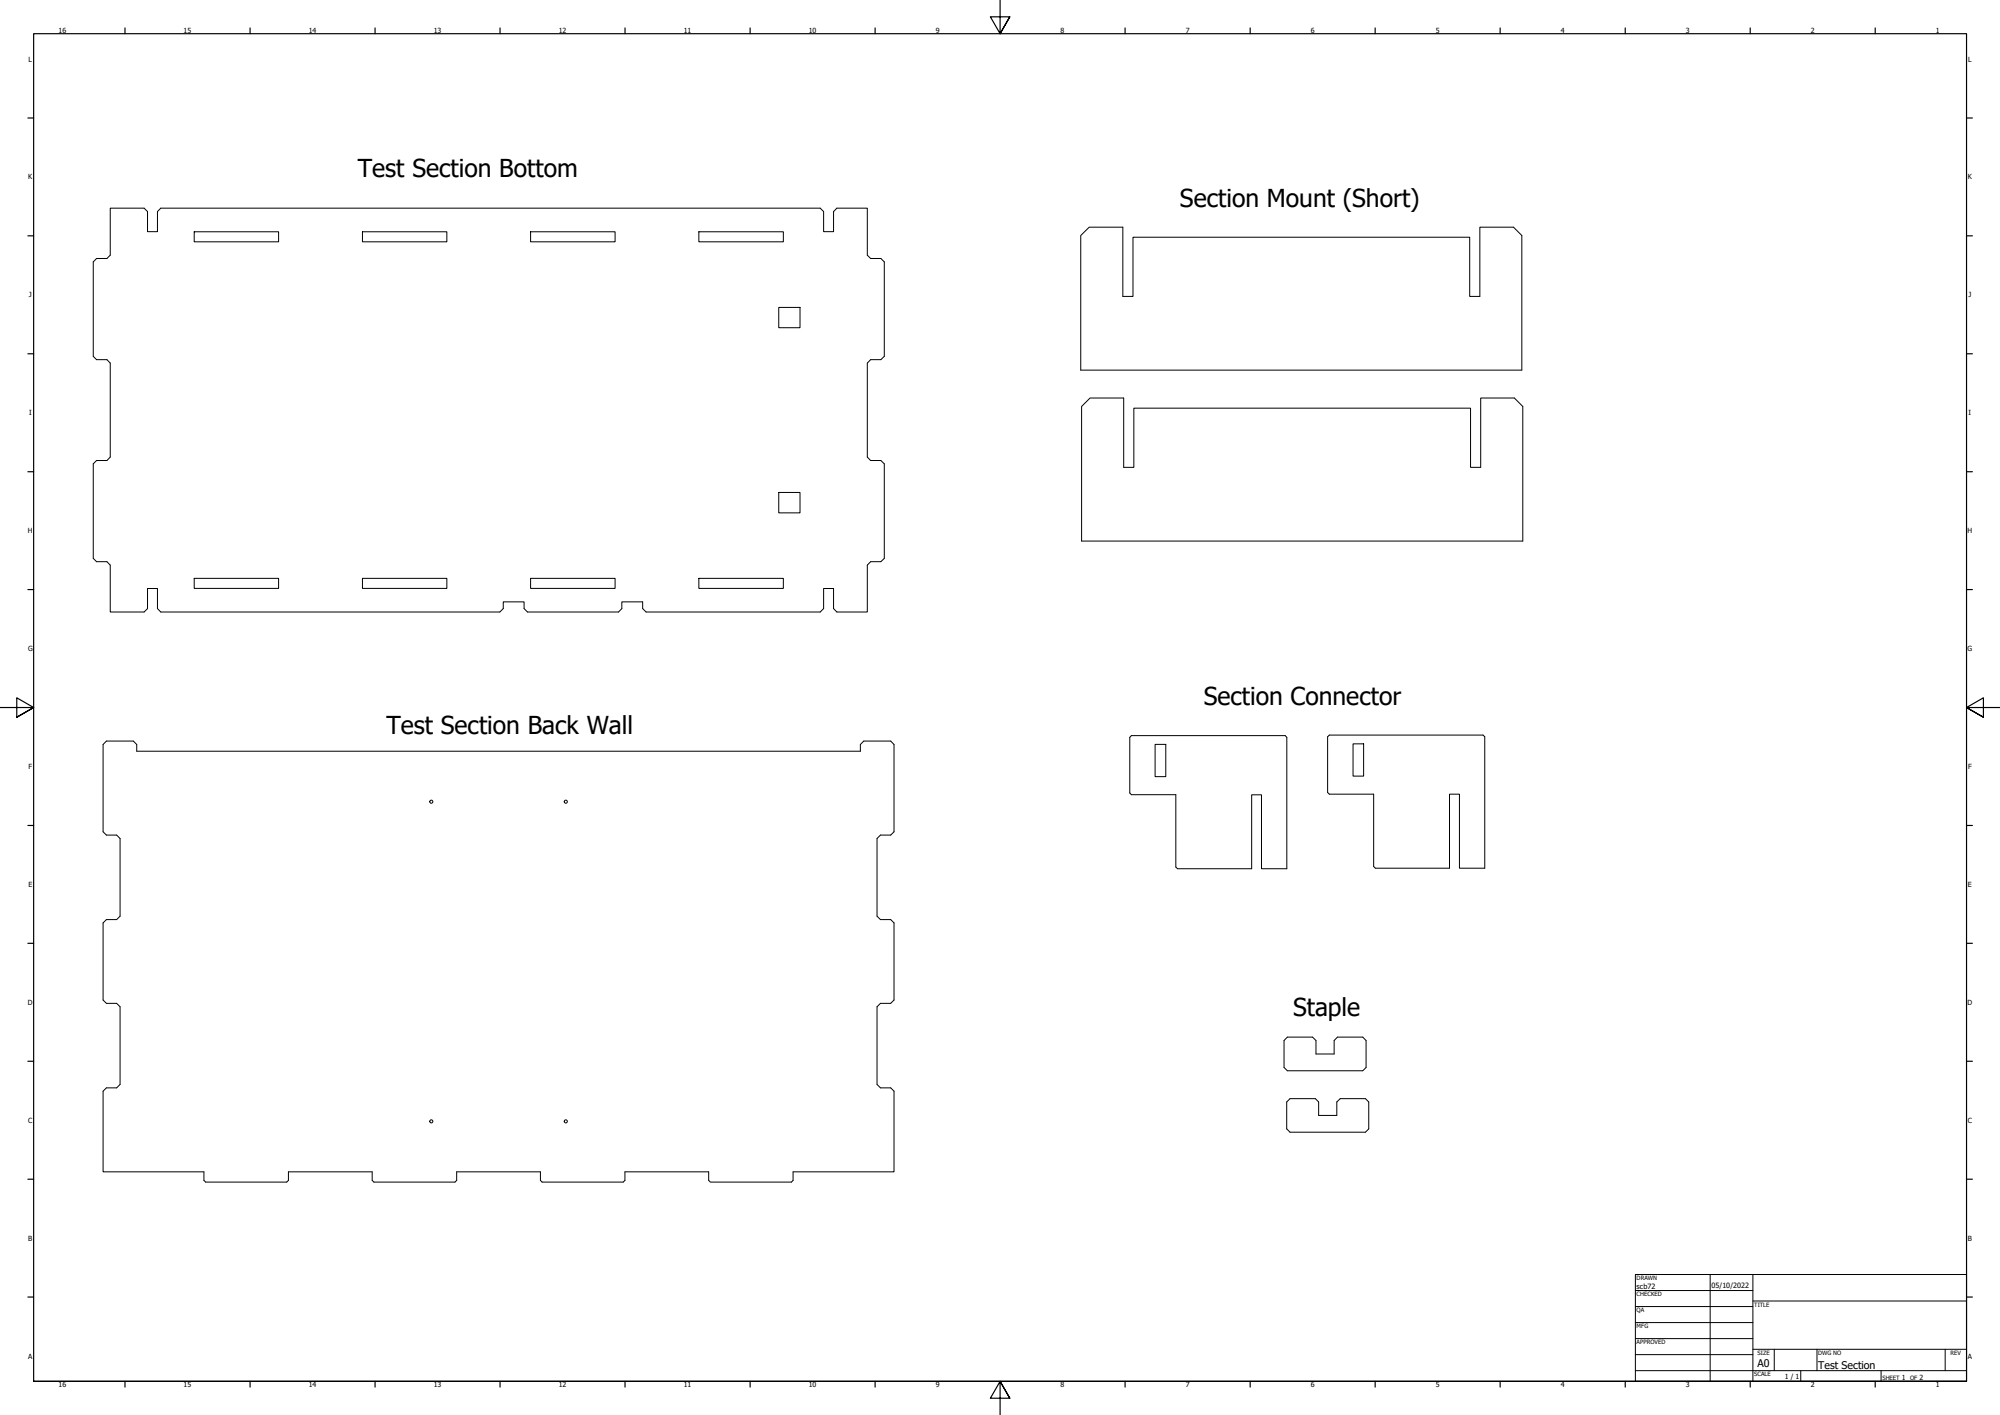
[picture p25: page 1]
Section Connector

Test Section Bottom

Section Mount (Short)

Test Section Back Wall

DRAWN scb72 | 05/10/2022

CHECKED

MFG

APPROVED

SIZE A0 | DWG NO Test Section | REV

SCALE 1 / 1 | | SHEET 1 OF 2
