MiniWindTunnelProject/The-Mini-Wind-Tunnel-Project/Mini Wind Tunnel Files/Countersink locations/Motorbox Bottom.pdf

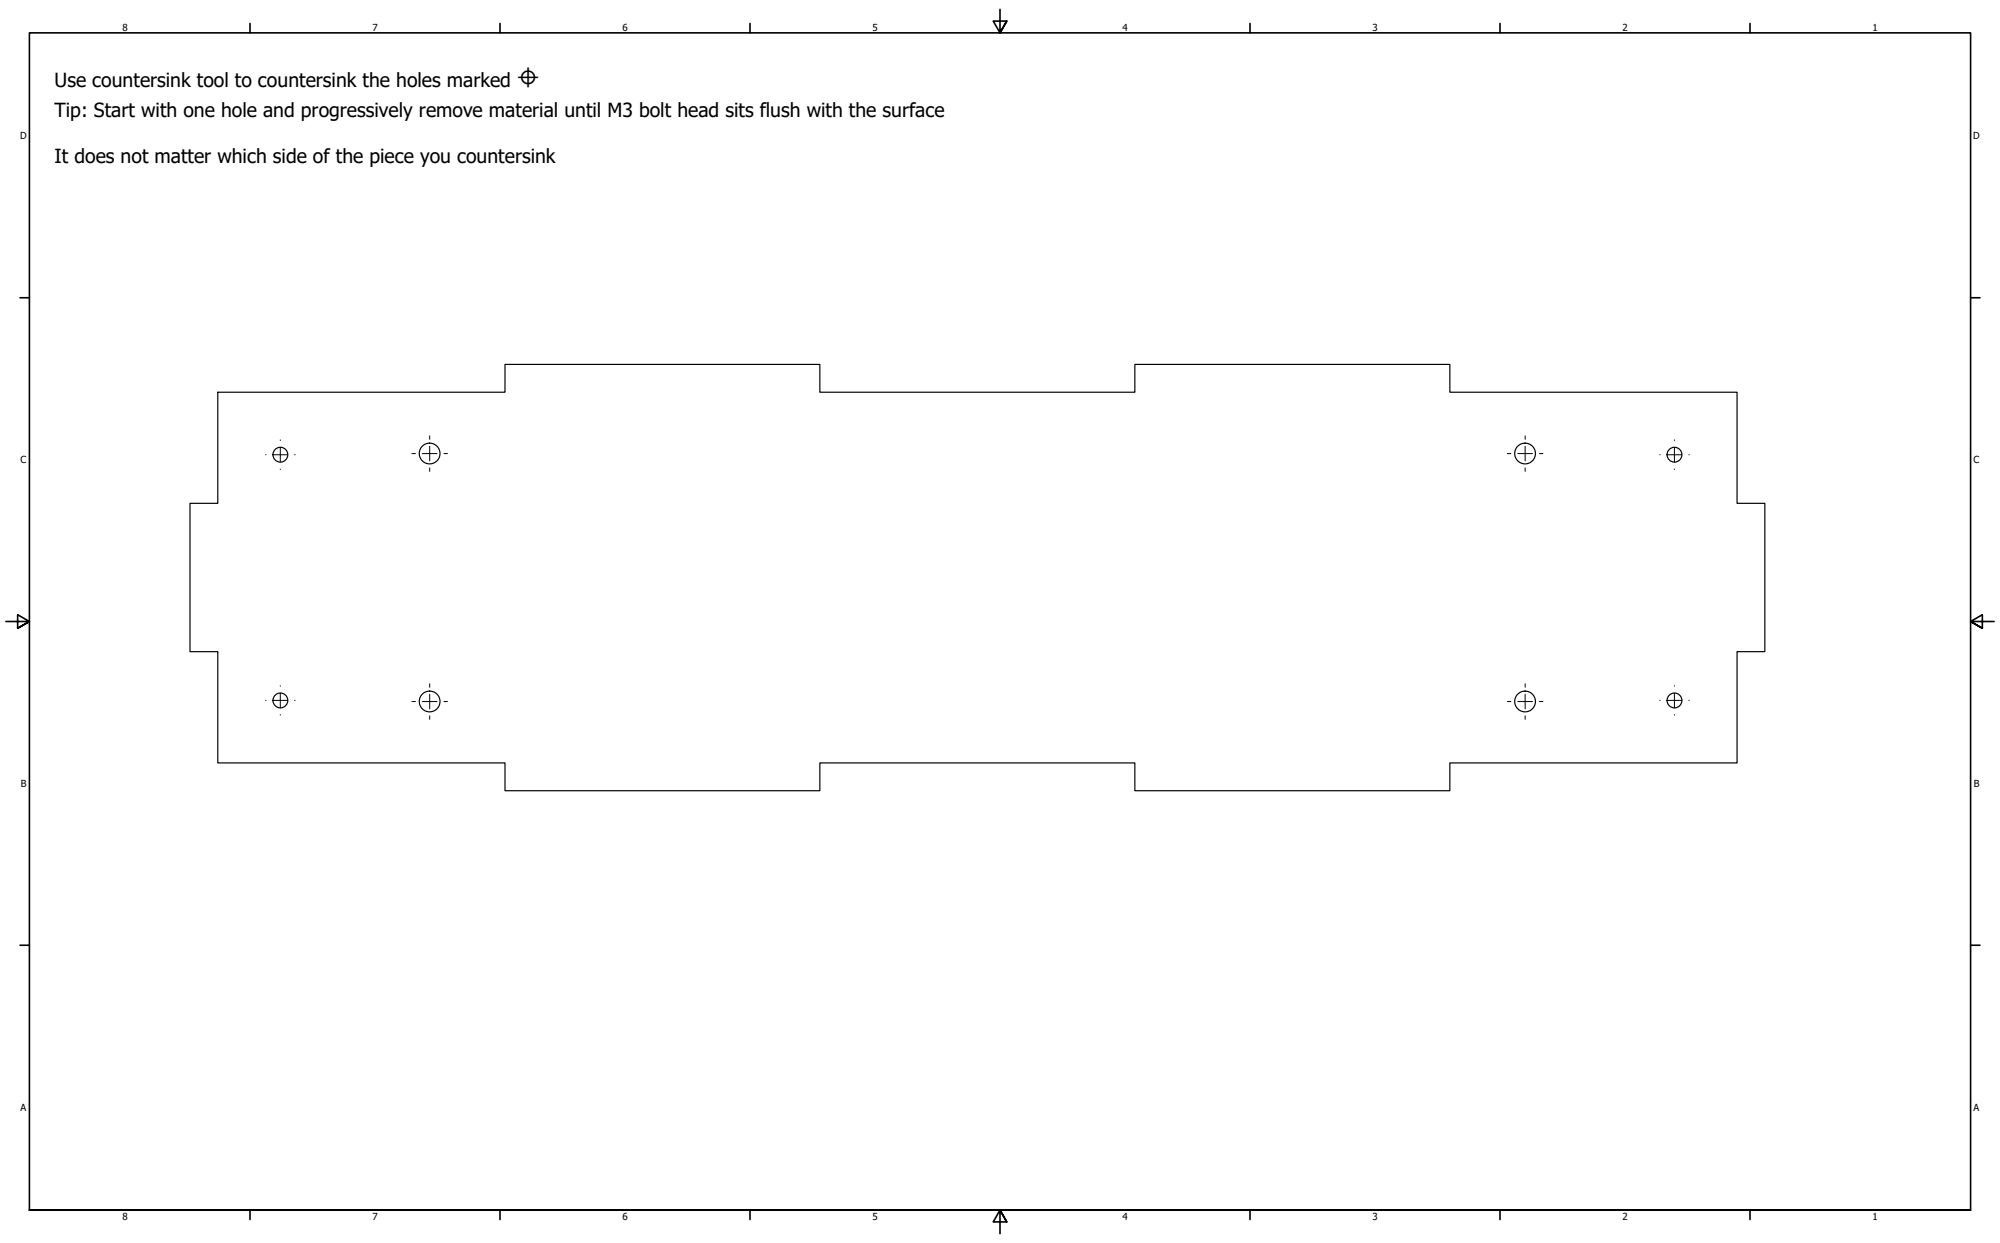
[picture p26: page 1]

Use countersink tool to countersink the holes marked ⌖
Tip: Start with one hole and progressively remove material until M3 bolt head sits flush with the surface

It does not matter which side of the piece you countersink
