MiniWindTunnelProject/The-Mini-Wind-Tunnel-Project/Mini Wind Tunnel Files/Countersink locations/Motorbox corner piece.pdf

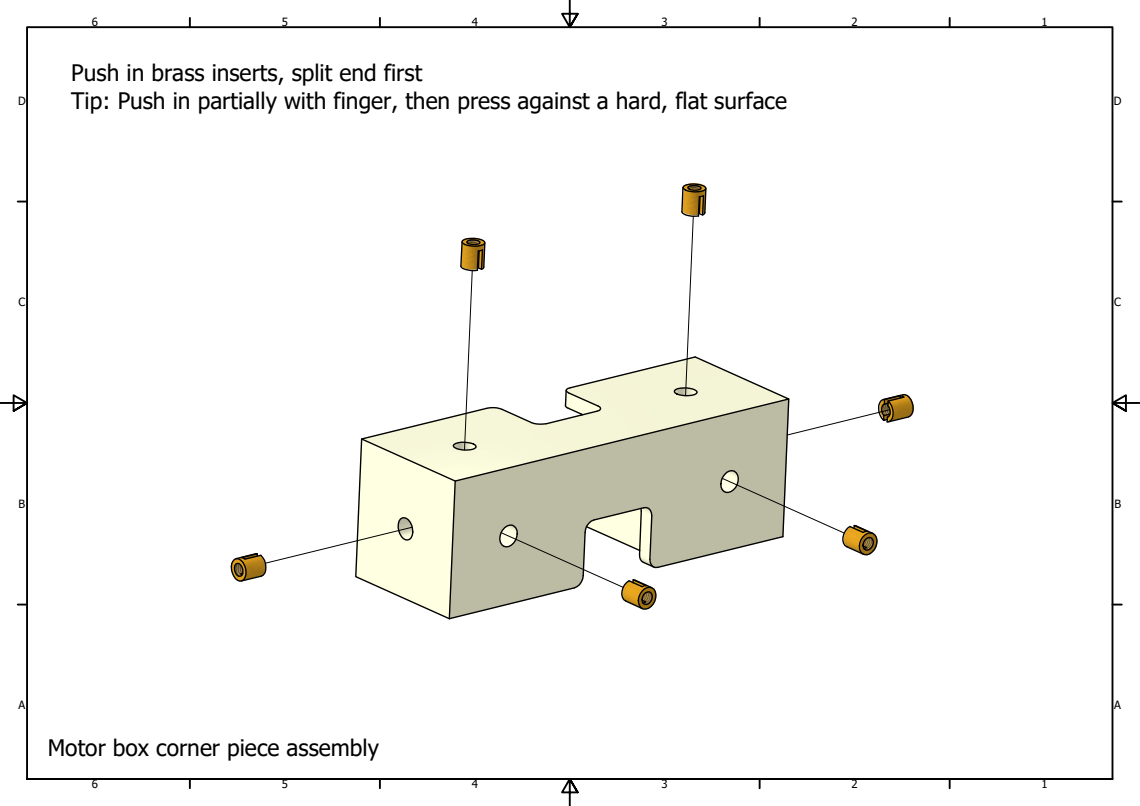
[picture p27: page 1]

Push in brass inserts, split end first
Tip: Push in partially with finger, then press against a hard, flat surface

Motor box corner piece assembly
