MiniWindTunnelProject/The-Mini-Wind-Tunnel-Project/Mini Wind Tunnel Files/Countersink locations/Motorbox Fan Back.pdf

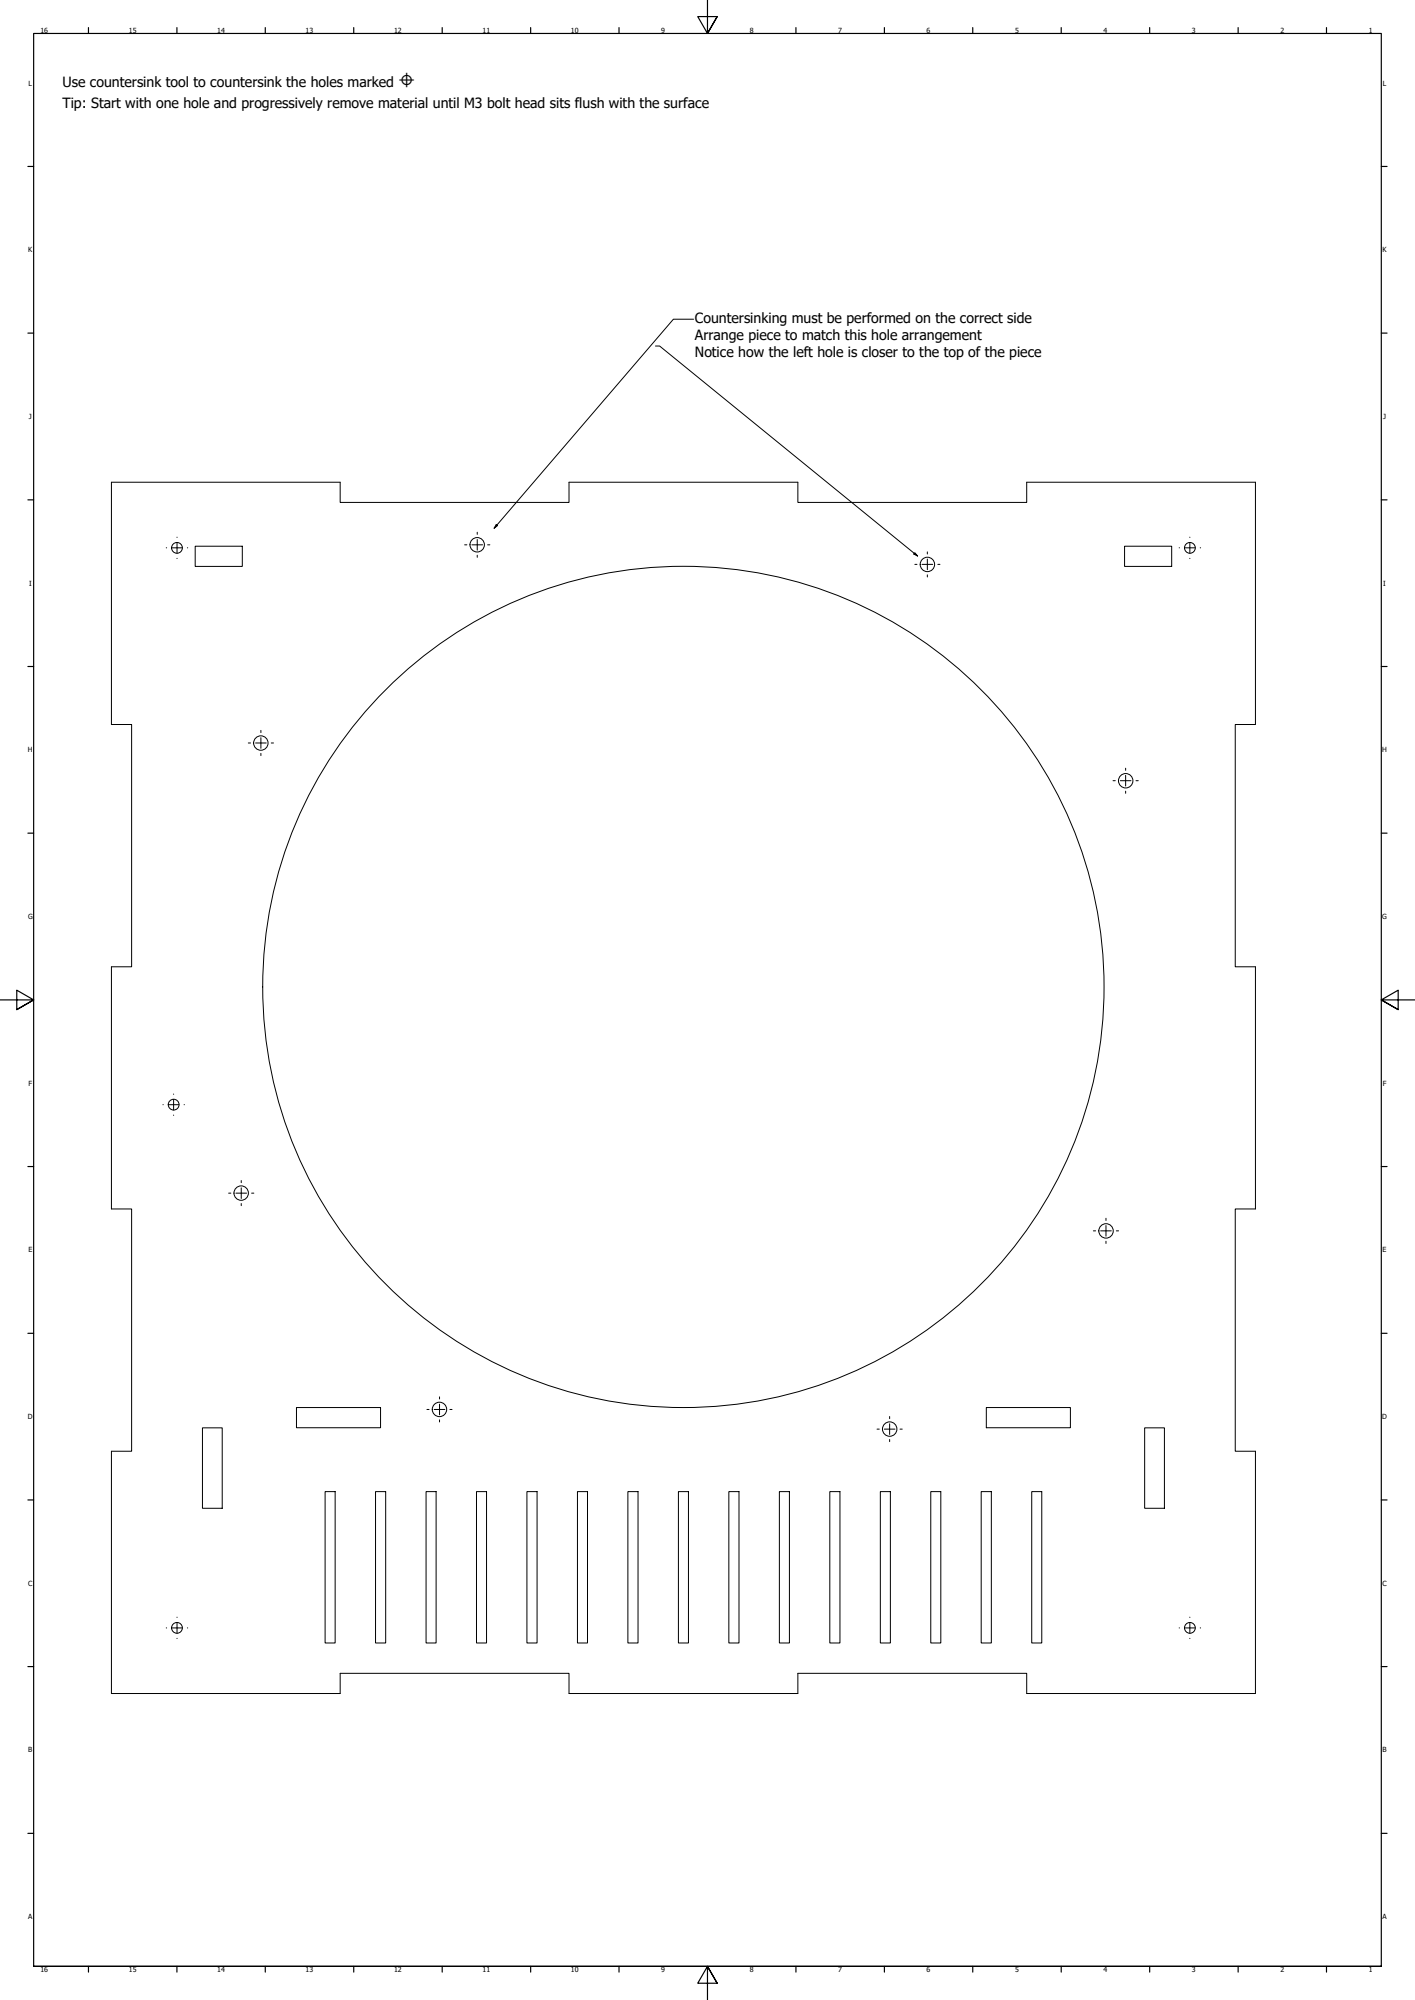
[picture p28: page 1]
Use countersink tool to countersink the holes marked ⌖

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

Countersinking must be performed on the correct side
Arrange piece to match this hole arrangement
Notice how the left hole is closer to the top of the piece
