MiniWindTunnelProject/The-Mini-Wind-Tunnel-Project/Mini Wind Tunnel Files/Laser Cut Drawings/6mm MDF/Contraction.pdf

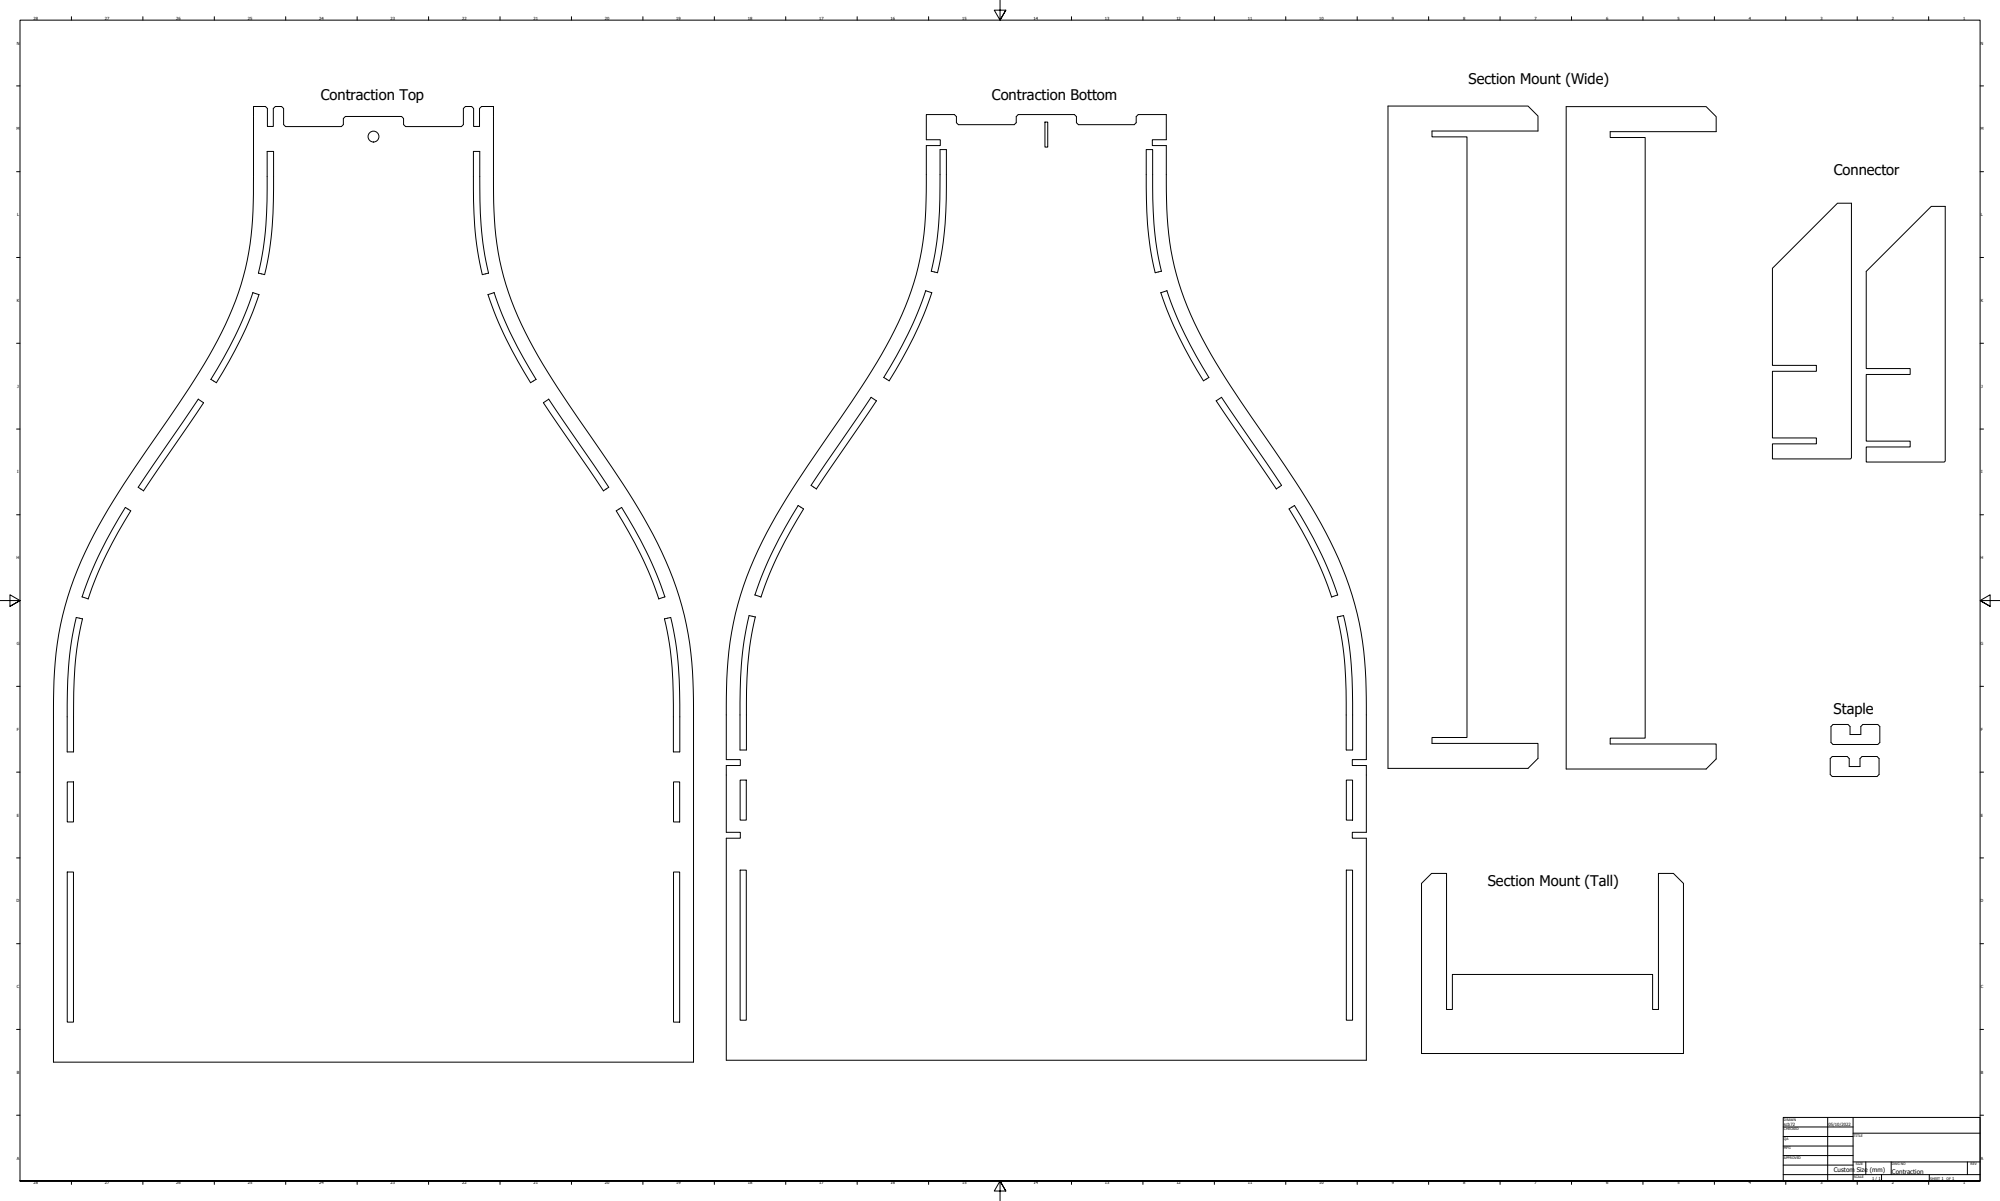
[picture p29: page 1]
SHEET 1 OF 1; DWG NO; Contraction Top; Contraction Bottom

Section Mount (Wide)

Section Mount (Tall)

DRAWN scb72 | 05/10/2022

CHECKED

MFG

APPROVED

Custom Size (mm)
