MiniWindTunnelProject/The-Mini-Wind-Tunnel-Project/Mini Wind Tunnel Files/Laser Cut Drawings/6mm MDF/Diffuser.pdf

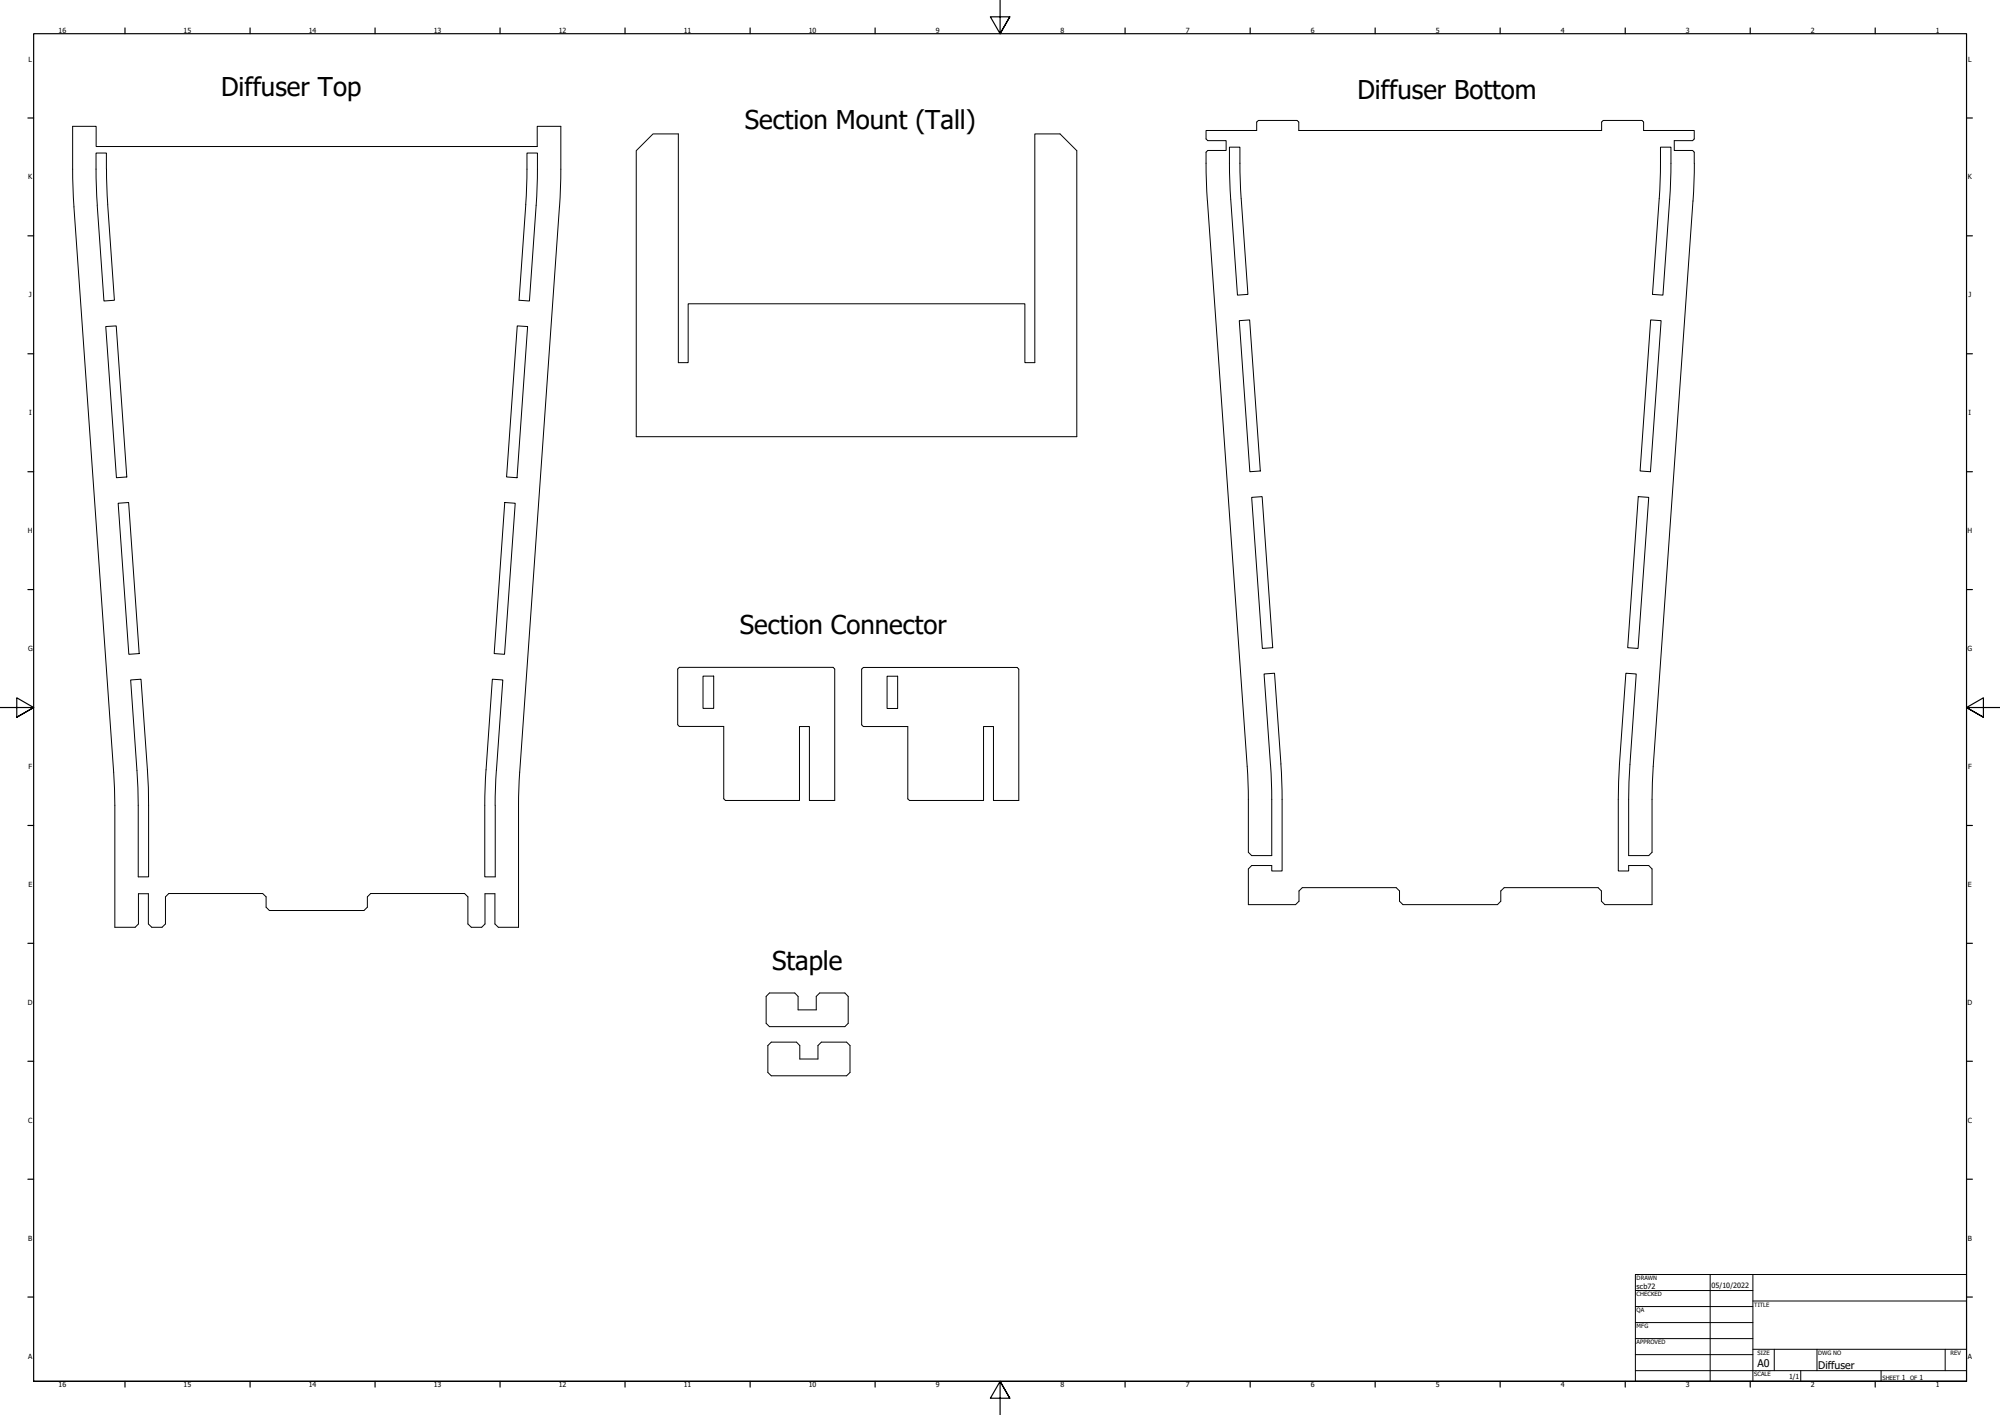
[picture p30: page 1]
Section Connector; Diffuser Top; Diffuser Bottom

Section Mount (Tall)

DRAWN scb72 | 05/10/2022

CHECKED

MFG

APPROVED

SIZE A0 | DWG NO Diffuser | REV

SCALE 1/1 | | SHEET 1 OF 1
