MiniWindTunnelProject/The-Mini-Wind-Tunnel-Project/Mini Wind Tunnel Files/Laser Cut Drawings/6mm MDF/Motorbox.pdf

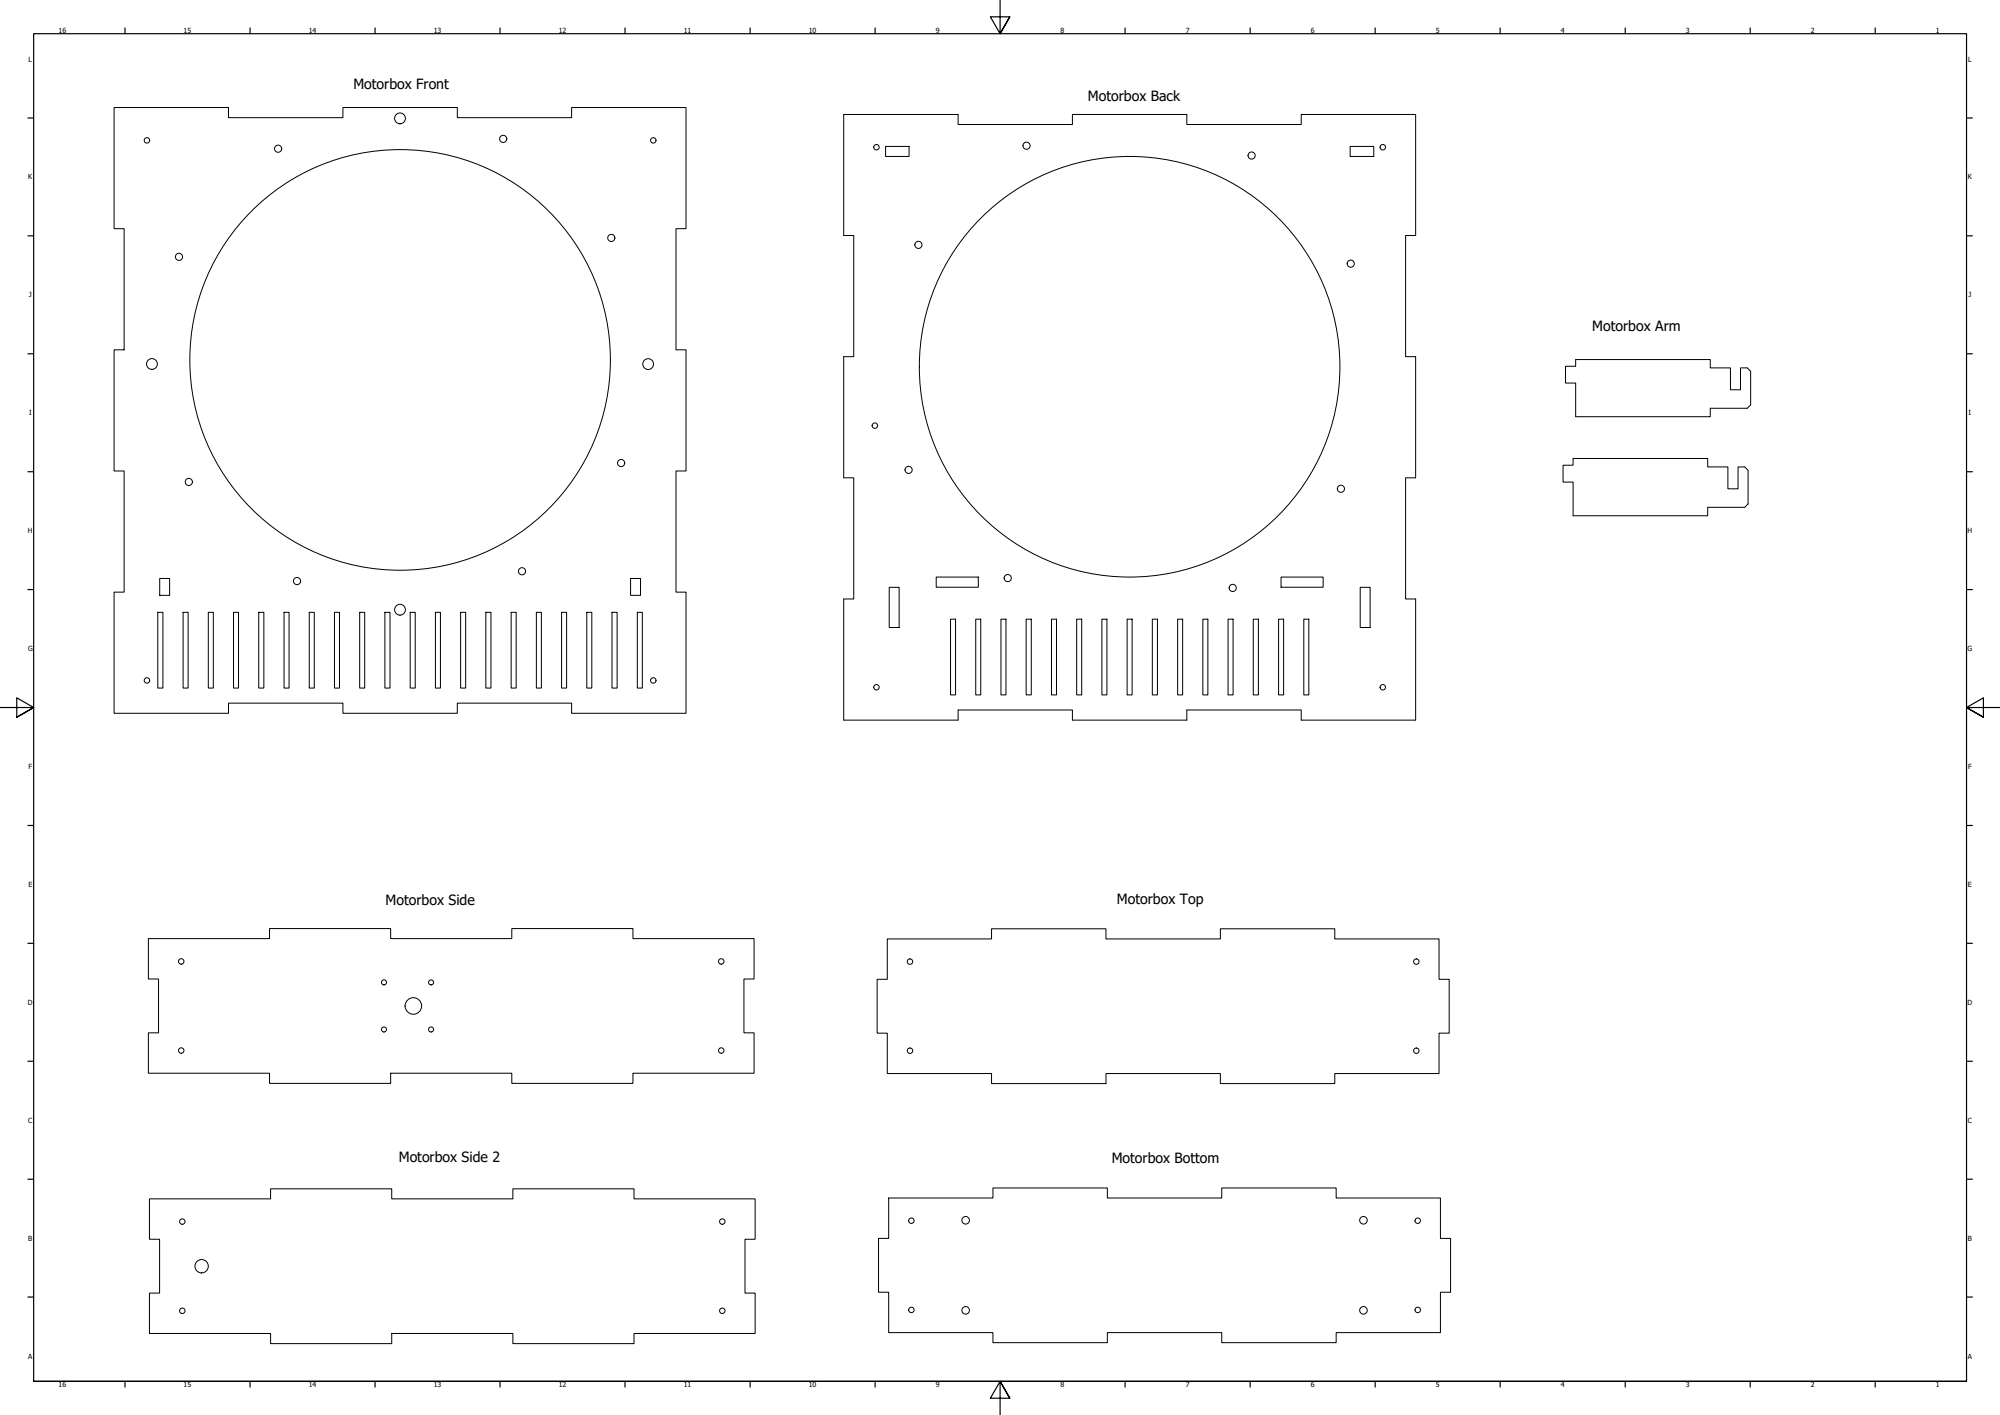
[picture p31: page 1]
Motorbox Front; Motorbox Back; Motorbox Side 2; Motorbox Side; Motorbox Bottom; Motorbox Top; Motorbox Arm
