MiniWindTunnelProject/The-Mini-Wind-Tunnel-Project/Mini Wind Tunnel Files/Assembly Drawings/Smoke Box/SmokeBox.pdf

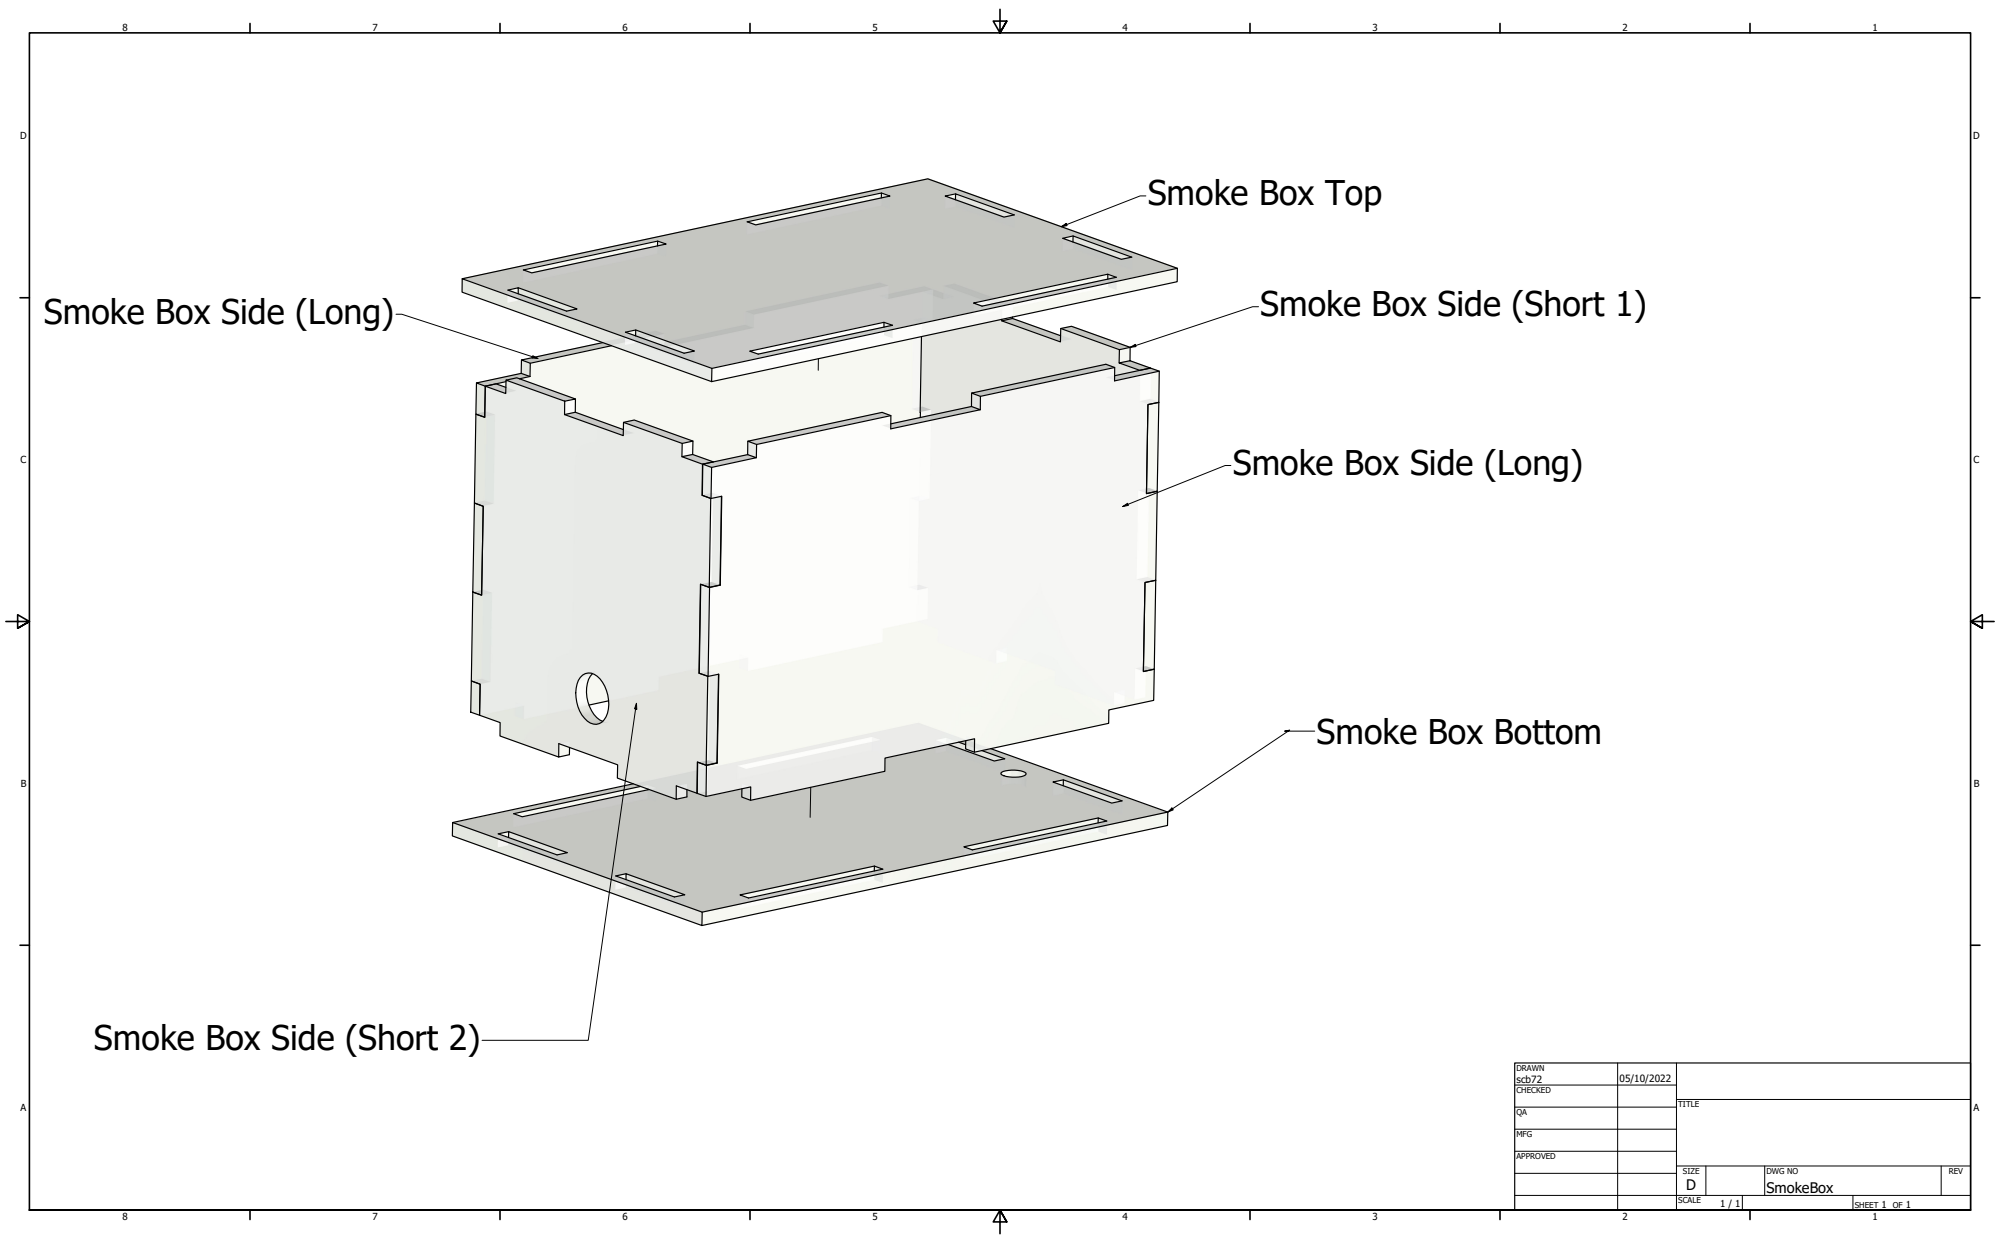
[picture p32: page 1]

Smoke Box Top

Smoke Box Side (Short 1)

Smoke Box Side (Long)

Smoke Box Bottom

Smoke Box Side (Short 2)

DRAWN scb72 | 05/10/2022

CHECKED

MFG

APPROVED

SIZE D | DWG NO SmokeBox | REV

SCALE 1 / 1 | | SHEET 1 OF 1
