MiniWindTunnelProject/The-Mini-Wind-Tunnel-Project/Mini Wind Tunnel Files/Laser Cut Drawings/6mm Acryllic/SmokeBox.pdf

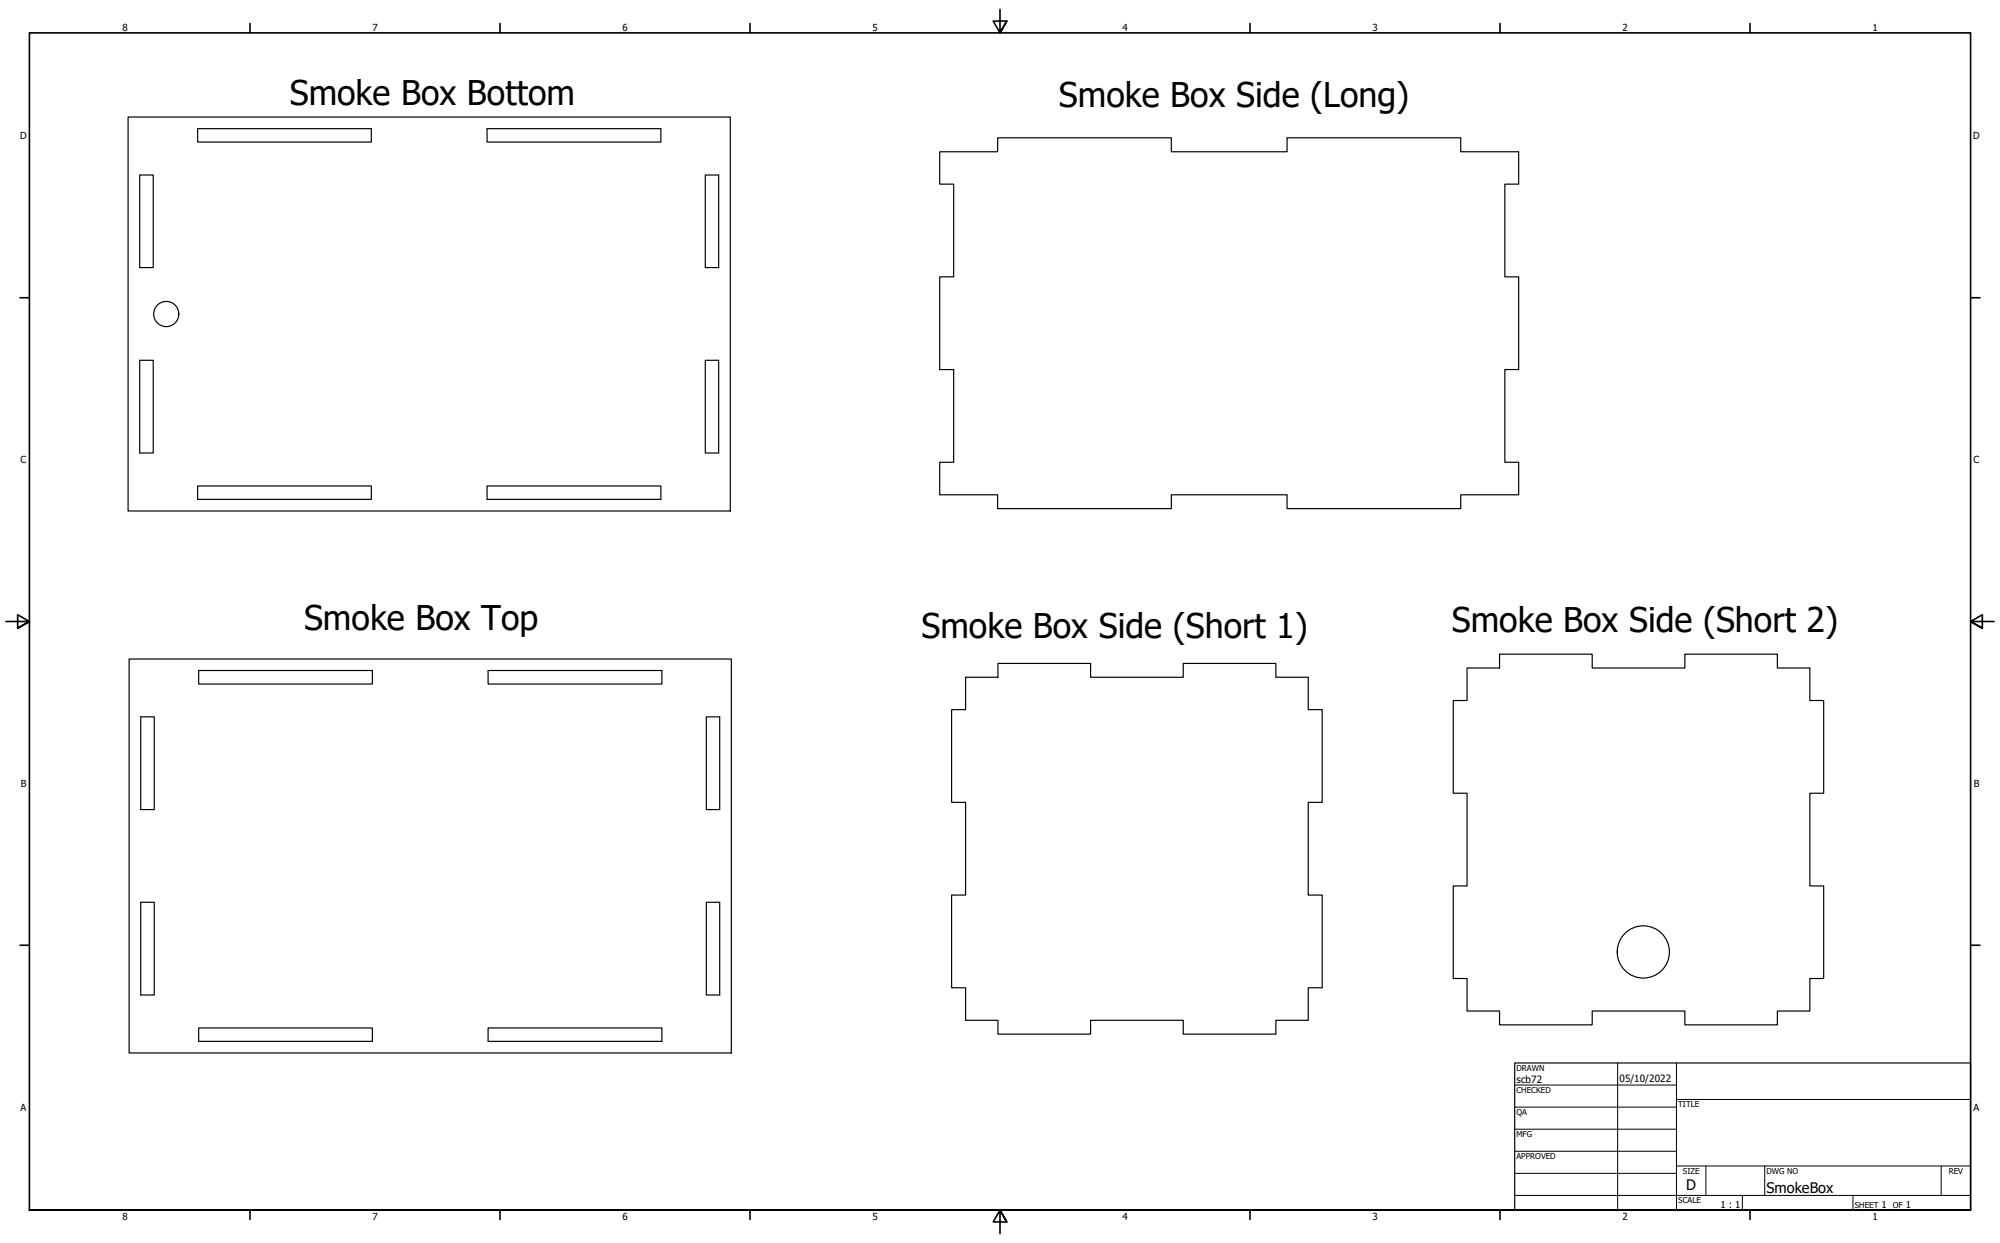
[picture p33: page 1]
Smoke Box Side (Short 1); Smoke Box Side (Short 2)

Smoke Box Bottom

Smoke Box Side (Long)

Smoke Box Top

DRAWN scb72 | 05/10/2022

CHECKED

MFG

APPROVED

SIZE D | DWG NO SmokeBox | REV

SCALE 1 : 1 | | SHEET 1 OF 1
