MiniWindTunnelProject/The-Mini-Wind-Tunnel-Project/Mini Wind Tunnel Files/Laser Cut Drawings/6mm Flex MDF/Contraction.pdf

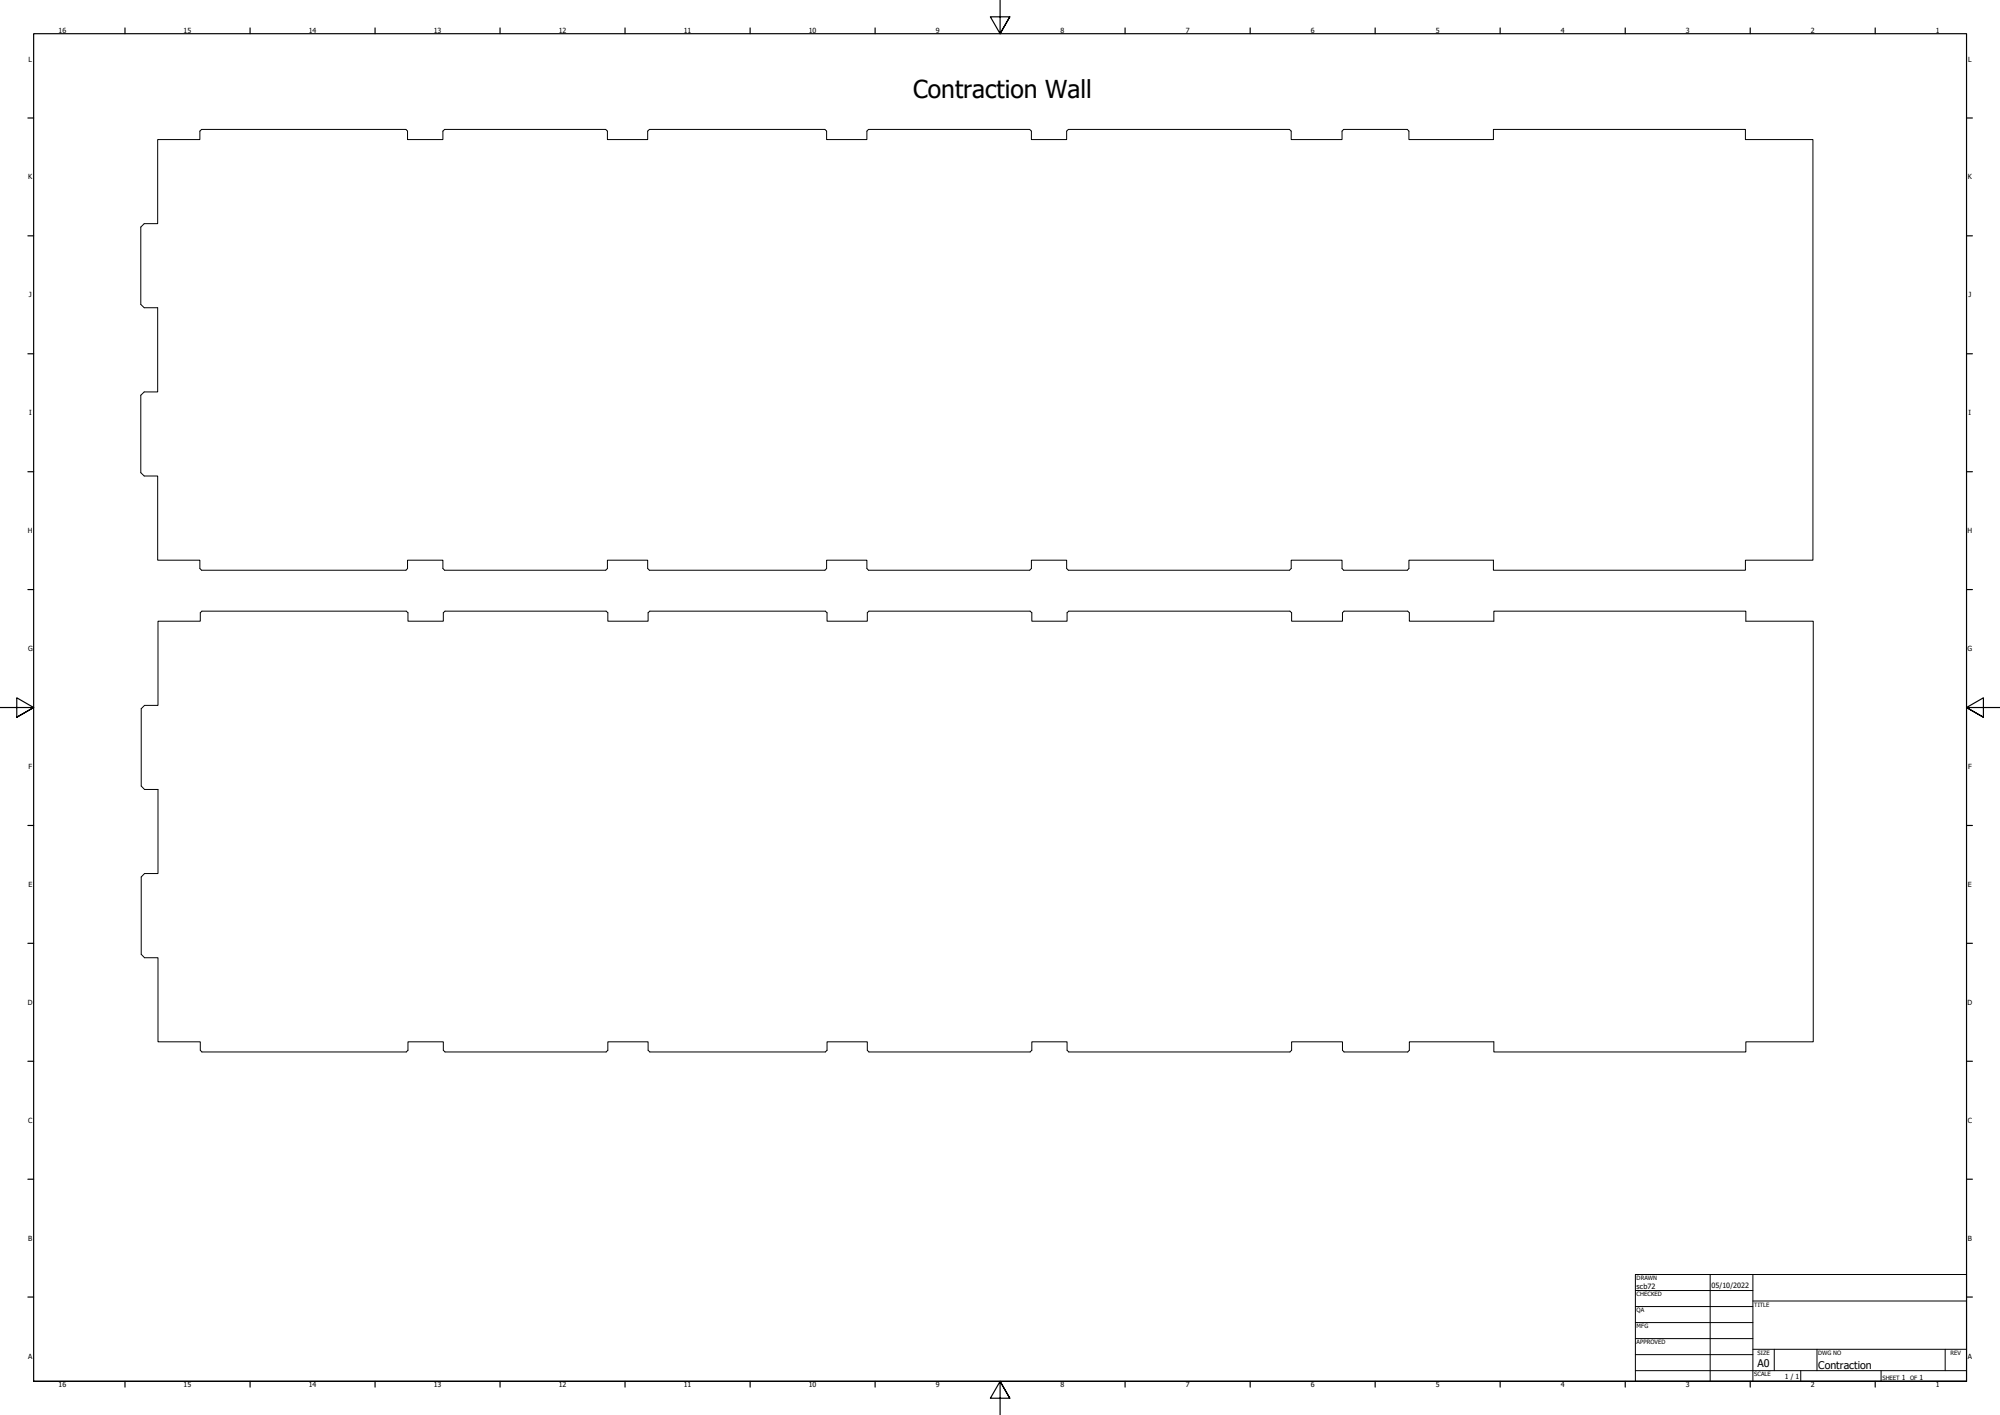
[picture p34: page 1]
Contraction Wall

DRAWN scb72 | 05/10/2022

CHECKED

MFG

APPROVED

SIZE A0 | DWG NO Contraction | REV

SCALE 1 / 1 | | SHEET 1 OF 1
