MiniWindTunnelProject/The-Mini-Wind-Tunnel-Project/(commit log)

2022-11-02 adding wind tunnel files
    [Contraction.dwg, Contraction.dxf, CornerPiece.ipt, CornerPiece.stl, CornerPiece.stp, Diffuser.dwg, Diffuser.dxf, LaserHolder.dwg]
2022-12-06 license and costs
    [Cost Sheet.xlsx]
